100dollarhacker/atomic_force_microscope/README.md

This repository holds the files for creating simple diy atomic force microscope.
