100dollarhacker/atomic_force_microscope/samples/van_der_vaals_force.png

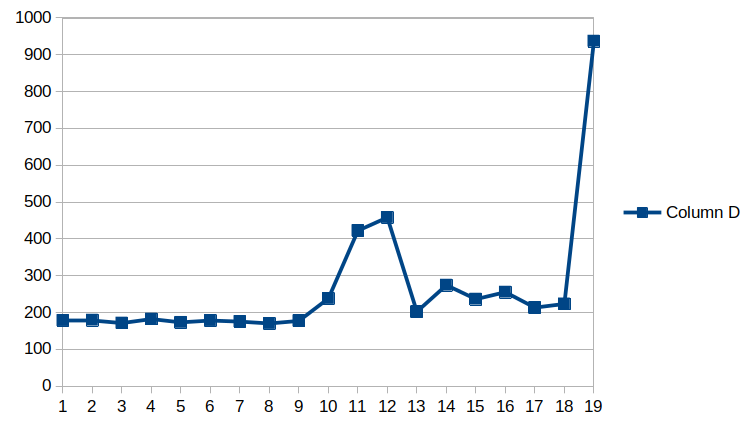
samples/van_der_vaals_force.png
