100dollarhacker/atomic_force_microscope/electric/AllBoardsBom.xlsx

PCBWay Bom Quotation, Product No.:T-2D39W751273A
Item # | *Designator | *Qty | *Mfg Part # | Description / Value | *Package/Footprint | *Unit Price(1 set) | *Total | *Delivery Time | *Actual Purchase Mfg Part # | *PCBWay Note | Customer Reply | PCBWay Update
1 | C4, C5, C6, C7, C8, C9 | 6 |  | 0.1uF『 』0.1UF-0603-25V-(+80/-20%)『 』0.1µF ceramic capacitors | 0603 | $0.098 | $0.588 |  | CC0603MRY5V8BB104
2 | 3C1, 3C3, 3C4, 3C11, 3C13, 3C15, 3C17 | 7 |  | 0.1uF『 』0.1UF-0603-50V-10%『 』0.1µF ceramic capacitors | 603 | $0.018 | $0.126 |  | CL10B104KB8NNNC
3 | 2C9, 2C11, 2C13 | 3 |  | 0.1uF『 』50V 10% X7R『 』CAPACITOR, European symbol | C0805 | $0.099 | $0.297 |  | 0805B104K500CT
4 | 2C1 | 1 |  | 1.0uF『 』1.0UF-0805-25V-10%『 』1µF ceramic capacitors | 0805 | $0.050 | $0.050 |  | 0805B105K250NT
5 | 1C13 | 1 |  | 1.0uF『 』1.0UF-0805『 』1µF ceramic capacitors 50V X7R 10% | 0805 | $0.050 | $0.050 |  | TCC0805X7R105K500DTS
6 | 3C6, 3C7 | 2 |  | 1.5nF『 』C-EUC0603 50v-10%『 』CAPACITOR, European symbol | 603 | $0.141 | $0.282 |  | 0603B152K500NT
7 | 3R4, 2R5,2R4 | 3 |  | 100k, 1/10W 1%『 』R-US_R0603『 』RESISTOR, American symbol | 603 | $0.041 | $0.123 |  | RC0603FR-07100KL
8 | C2, C3 | 2 |  | 100pF『 』100PF-0603-50V-5%『 』100pF/0.1nF ceramic capacitors | 0603 | $0.172 | $0.344 |  | 0603CG101J500NT
9 | 2R14, 2R15, 2R20 | 3 |  | 10k『 』RC-MASTER-SMD_R_0603MP『 』RESISTOR | RC-MASTER-SMD_R0603MP | $0.043 | $0.129 |  | RC0603FR-0710KL
10 | R6 | 1 |  | 10M『 』10MOHM-0603-1/4W-5%『 』1MΩ resistor | 0603 | $0.139 | $0.139 |  | ESR03EZPJ106
11 | 2C3, 2C5 | 2 |  | 10nF『 』10NF-0603-50V-10%『 』0.01uF/10nF/10,000pF ceramic capacitors | 0603 | $0.050 | $0.100 |  | CC0603KRX7R9BB103
12 | C1,3C2,1C15, 1C17 | 4 |  | 10nF『 』10NF-0603-50V-10%『 』0.01uF/10nF/10,000pF ceramic capacitors | 0603 | $0.066 | $0.264 |  | CC0603KRX7R9BB103
13 | 1C1, 1C10 | 2 |  | 10u『 』C-USC0603『 』CAPACITOR, American symbol 50V X7R 10% | 0603 | $0.078 | $0.156 |  | GRM188R61E106KA73D | 10uF ±10% 25V, X5R
14 | 1C2 | 1 |  | 10u『 』C-USC1210『 』CAPACITOR, American 50V X7R 10% | 1210 | $0.504 | $0.504 |  | 1210B106K500NT
15 | 2C8, 2C10, 2C12 | 3 |  | 10uF『 』10UF-0805-10V-10%『 』10.0µF ceramic capacitors | 0805 | $0.050 | $0.150 |  | TCC0805X5R106K100FT
16 | 2C2, 2C4, 2C6, 2C7 | 4 |  | 10uF『 』10UF-0805-25V-10%『 』10.0µF ceramic capacitors | 0805 | $0.050 | $0.200 |  | TCC0805X5R106K250FT
17 | 1C14, 1C16, 1C18, 1C19 | 4 |  | 10uF『 』10UF-0805-25V-10%『 』10.0µF ceramic capacitors 50V X7R 10% | 0805 | $0.105 | $0.420 |  | CL21B106KAYQNNE | 10uF ±10% 25V
18 | C10, C11 | 2 |  | 10uF『 』10UF-0805-50V-10%『 』10.0µF ceramic capacitors | 0805 | $0.147 | $0.294 |  | CL21A106KBYQNNE
19 | 3C5, 3C8, 3C12, 3C14, 3C16, 3C18 | 6 |  | 10uF『 』10UF-0805-50V-10%『 』10.0µF ceramic capacitors | 805 | $0.134 | $0.804 |  | CL21A106KBYQNNE
20 | 3R5 | 1 |  | 1k, 1/10W 1%『 』R-US_R0603『 』RESISTOR, American symbol | 603 | $0.127 | $0.127 |  | RC0603FR-071KL
21 | 1D2, 1D3, 1D5, 1D6 | 4 |  | 1n4007 (A7)『 』DIODE A7『 』DIODE | SOD123 | $0.603 | $2.412 | 7-10 Workdays | PMEG200G20ELR-QX
22 | 1C9, 1C11 | 2 |  | 1u『 』C-USC0603『 』CAPACITOR, American symbol 50V X7R 10% | 0603 | $0.050 | $0.100 |  | 0603B105K500NT
23 | 1C3 | 1 |  | 1u『 』C-USC1210『 』CAPACITOR, American symbol 50V X7R 10% | 1210 | $0.134 | $0.134 |  | CC1210KKX7R9BB105
24 | 2U$2, 2U$4, 2U$6, 2U$8 | 4 |  | 1uF『 』10% X7R『 』Generic chip capacitor | 0603 | $0.237 | $0.948 | 7-10 Workdays | 885012106030
25 | 2U$1, 2U$3, 2U$5, 2U$7 | 4 |  | 2.2uf『 』10% X7R『 』Generic chip capacitor | 0603 | $0.063 | $0.252 |  | GRM188R61E225KA12J
26 | 2R1,R5,1R3 | 3 |  | 220『 』220OHM-0603-1/10W-1%『 』220Ω resistor | 0603 | $0.054 | $0.162 |  | RC0603FR-07220RL
27 | 1C8 | 1 |  | 220u『 』CAPACITOR-P140CLH-1014『 』POLARIZED CAPACITOR, American symbol 50V X7R 10% | 140CLH-1014 | $1.764 | $1.764 | 7-10 Workdays | EEE-FP1H221AV
28 | 3Y1 | 1 |  | 25MHZ『 』OSCILLATORSMD-5X3『 』Oscillators (Generic) url: https://www.ebay.com/itm/364220200646 | 5X3.2mm | $2.245 | $2.245 | 7-10 Workdays | FT3MHUPM25.0-T1
29 | 1R6, 1R7 | 2 |  | 300k『 』300KOHM-0603-1/10W-1%『 』300KΩ 1% | 0603 | $0.086 | $0.172 |  | RC0603FR-07300KL
31 | 2R16, 2R17, 2R18, 2R19 | 4 |  | 30k『 』1/10W 1%『 』RESISTOR | RC-MASTER-SMD_R0603MP | $0.038 | $0.152 |  | RC0603FR-0730KL
32 | R4 | 1 |  | 4.7k『 』4.7KOHM-0603-1/10W-1%『 』4.7kΩ resistor | 0603 | $0.129 | $0.129 |  | RC0603FR-074K7L
33 | 2U$9 | 1 |  | 4.7uf『 』10% X7R『 』Generic chip capacitor | RESC0603_M | $0.147 | $0.147 |  | 06033D475KAT2A
34 | R3，R2 | 2 |  | 470『 』470OHM-0603-1/10W-1%『 』470Ω resistor | 0603 | $0.077 | $0.154 |  | RC0603FR-07470RL
35 | R2 | 1 |  | 470『 』47OHM-0603-1/10W-1%『 』47Ω resistor | 0603 |  |  |  | RMC1/16K4702FTP | [DNP不要贴];
36 | R1 | 1 |  | 47k『 』47KOHM-0603-1/10W-1%『 』47kΩ resistor | 0603 | $0.152 | $0.152 |  | RC0603FR-0747KL
37 | 3R1,3R2,3R6, 3R7, 3R8, 3R9 | 4 |  | 5.6k 1/10W 1%『 』R-US_R0603『 』RESISTOR, American symbol | 603 | $0.038 | $0.152 |  | RC0603FR-075K6L
38 | 2R6, 2R7, 2R8, 2R9, 2R10, 2R11, 2R12, 2R13 | 8 |  | 5k『 』1/10W-1%『 』RESISTOR | RC-MASTER-SMD_R0603MP | $0.019 | $0.152 |  | RTT035001FTP
39 | L3, L141 | 2 |  | 60Ohm@100 MHz『 』WE-CBF_0603_74279267_WB_HS『 』High Speed 60Ohm@100 MHz 110Ohm@650 MHz WE-CBF SMD EMI Suppression Ferrite Bead https://www.we-online.com/redexpert/spec/74279267?ae 2000mA SMT | 0603 | $0.315 | $0.630 |  | 74279267
40 | 3R3 | 1 |  | 7.2k， 1/10W 1%『 』R-US_R0603『 』RESISTOR, American symbol | 603 | $0.105 | $0.105 |  | AR03FTDX7201NA
41 | 1IC4 | 1 | 7805DT | 7805DT『 』7805DT『 』Positive VOLTAGE REGULATOR | TO252 | $0.440 | $0.440 |  | MC7805BDTG
42 | 1IC2 | 1 | 7815DT | 7815DT『 』7815DT『 』Positive VOLTAGE REGULATOR | TO252 | $0.592 | $0.592 |  | MC7815BDTRKG
43 | 2U2 | 1 |  | AD5696RARUZ-RL7RU_16_ADI-M『 』Analog Devices Inc『 』Quad, 26bit nano DAC. | RU_16_ADI-M | $29.458 | $29.458 | 7-10 Workdays | AD5696RARUZ
44 | U3 | 1 | AD8675ARMZ-REEL | AD8675ARMZ-REEL『 』Analog Devices『 』36 V Precision, 2.8 nV/√Hz Rail-to-Rail Output Op Amp | MSOP-8 | $2.730 | $2.730
45 | U2 | 1 | AD8676ARMZ | AD8676ARMZ『 』Analog Devices『 』Ultra Precision, 36 V, 2.8 nV/√Hz Dual RRO Op Amp | MSOP-8 | $4.410 | $4.410
46 | 3U1 | 1 | AD9833BRM | AD9833BRM『 』Analog Devices『 』Direct Digital Synthesizer 25MHz 1-DAC 10-Bit Serial | MSOP-10 | $19.918 | $19.918 | 7-10 Workdays | AD9833WBRMZ-REEL
47 | J1 | 1 |  | CONN_05PTH_LONGPADS『 』Multi connection point. Often used as Generic Header-pin footprint for 0.1 inch spaced/style header connections | 1X05_LONGPADS |  |  |  | HWS16310 | [DNP不要贴];
48 | 2U3 | 1 | LM324KAD | LM324KAD『 』Texas Instruments『 』Quad, 30-V, 1.2-MHz, 3-mV offset voltage | SOIC-14 | $0.630 | $0.630
49 | 3U3 | 1 | LM324KAD | LM324KAD『 』Texas Instruments『 』Quad, 30-V, 1.2-MHz, 3-mV offset voltage | SOIC-14 | $0.630 | $0.630
50 | 3U2 | 1 | LM339D | LM339D『 』Texas Instrument『 』Quad differential | SSOIC-14 | $0.919 | $0.919
51 | 2U1，1U2 | 2 | LTC3260EMSE#PBF | LTC3260EMSE#PBF『 』Analog Devices『 』Low Noise Dual Supply Inverting Charge Pump | MSOP-16 | $6.843 | $13.686
52 | U2 | 1 | LTC3260EMSE#PBF | LTC3260EMSE#PBF『 』LTC3260EMSE#PBF『 』Low Noise Dual Supply Inverting Charge Pump | MSOP-16_MSE |  |  |  |  | [DNP不要贴];
53 | U4 | 1 | OPA656U | OPA656U『 』Texas Instruments『 』Wideband, Unity Gain Stable FET-Input Operational Amplifier | SOIC-8 | $11.230 | $11.230 |  | OPA656UB/2K5
54 | 1J1 | 1 |  | POWER_JACKPOWER_JACK_SLOT『 』POWER_JACKPOWER_JACK_SLOT『 』Power Jack Connector 5.5mmx2.1mm | POWER_JACK_PTH_SLOT | $0.672 | $0.672 |  | PJ-102AH
55 | 3U4 | 1 | SN74LVC1G86DCKRG4 | SN74LVC1G86DCKRG4『 』Texas Instruments『 』Single 2-input, 1.65-V to 5.5-V XOR (exclusive OR) gate | SC70-5 | $0.414 | $0.414 | 7-10 Workdays
 | 1R4, 1R5, 2R3, 2R2 | 4 |  | 910K Ohm, 1/10W 1% | 0603 |  |  |  |  |  | New added
56 | USB TYPE A CONNECTOR | 1 | USBR-A-S-S-O-TH | USBR-A-S-S-O-TH『 』USBR-A-S-S-O-TH | SAMTEC_USBR-A-S-S-O-TH J4 | $2.674 | $2.674 | 7-10 Workdays
 |  |  |  |  |  | Component Cost | $103.51
 |  |  |  |  |  | Assembly Cost | $88.00
 |  |  |  |  |  | PCB Cost | $81.61
 |  |  |  |  |  | V0 Member 0% off | $0.00
 |  |  |  |  |  | All Total 1 Sets | $273.12
 |  |  |  |  |  | Build time | 23-25 days
