100dollarhacker/atomic_force_microscope/OpenAFM__converted_files/main board BOM.xlsx

Description | Example URL | Quantity | Label on PCB
20 Ohm surface mount resistor 0805 | http://china.rs-online.com/web/p/surface-mount-fixed-resistors/7217615/ | 1 | R7
1k surface mount resistors 0805 | http://china.rs-online.com/web/p/surface-mount-fixed-resistors/2230427/ | 1 | R1
4k7 surface mounts resistor 0805 | http://china.rs-online.com/web/p/surface-mount-fixed-resistors/2230528/ | 2 | R2, R3
10uF capacitor | http://china.rs-online.com/web/p/aluminium-capacitors/0117035/ | 3 | U4, C5, U8
10 pin female header | http://china.rs-online.com/web/p/pcb-sockets/7655745/ | 3 | J1, J5, Header for Arduino
2 pin male header | http://china.rs-online.com//web/p/pcb-headers/2518086/ (http://china.rs-online.com/web/p/pcb-headers/2518086/) | 2 | J6, J7,J3
220uF capacitors | http://china.rs-online.com/web/p/aluminium-capacitors/3150726/ | 2 | C16, C23
500k surface mount resistors 0805 | http://china.rs-online.com/web/p/surface-mount-fixed-resistors/6791437/ | 1 | R8
2A 100ohm ferrite bead | http://china.rs-online.com/web/p/ferrite-beads/6694159/?searchTerm=742792312 | 2 | U3, U34
L7809CV voltage regulator IC (TO-220V) | http://china.rs-online.com//web/p/linear-voltage-regulators/7140666/ (http://china.rs-online.com/web/p/linear-voltage-regulators/7140666/) | 1 | U6
L7805CV voltage regulator IC (TO-220V) | http://china.rs-online.com/web/p/linear-voltage-regulators/2988514/ | 1 | U7
LM4040 (SOT23) | http://china.rs-online.com/web/p/voltage-references/5457675/ | 1 | U9
24 pin 0.5mm pitch connector | http://uk.rs-online.com/web/p/fpc-connectors/8882721/ | 1 | U15
TVS SMB diode | http://china.rs-online.com//web/p/tvs-diodes/6287691/ (http://china.rs-online.com/web/p/tvs-diodes/6287691/) | 1 | U21
SPswitch on-off-on | http://china.rs-online.com/web/p/toggle-switches/1900557/ | 1 | U32
LM317TG single linear voltage regulator | http://china.rs-online.com/web/p/linear-voltage-regulators/5166240/ | 1 | U33
1uF SMT capacitors | http://china.rs-online.com/web/p/ceramic-multilayer-capacitors/4515770/ | 4 | C1, C3, C4, C17
100nF SMT capacitors | http://china.rs-online.com/web/p/ceramic-multilayer-capacitors/2644416/ | 2 | C2,C8
3 pin male header | http://china.rs-online.com/web/p/pcb-headers/2518092/ | 2 | J2, J4
