100dollarhacker/atomic_force_microscope/OpenAFM__converted_files/Piezo BOM.xlsx

Description | Quantity | URL | Comments | Positions on board
3.2uF surface mount capacitors 0805 | 6 | http://china.rs-online.com/web/p/ceramic-multilayer-capacitors/6911161/ | Can vary from 3-3.5 uF | DaC, Cref, Ca, Cd, Cc, Cb
10k surface mount resistors 0805 | 3 | http://china.rs-online.com/web/p/surface-mount-fixed-resistors/2230562/ | Can vary from 10 to 50kOhm | Rdv1, Rdv2,Rdr
1uF surface mount capacitors 0805 | 1 | http://china.rs-online.com/web/p/ceramic-multilayer-capacitors/4515770/ | Must be 1uF | Cf
5k surface mount resistors 0805 | 8 | http://china.rs-online.com/web/p/surface-mount-fixed-resistors/6791569/ | Can vary from 4.8k to 5.2k | Ra1, Rb1, Rc1, Rd1, Rfa, Rfd, Rfc, Rfb
DAC (AD5696RARUZ) | 1 | http://china.rs-online.com/web/p/general-purpose-dacs/8065471/ |  | DAC1
LTC3260 | 1 | http://china.rs-online.com/web/p/charge-pumps/8516768/ | mounted so that pin 1 is next to the dot | <Unlabelled>
100k surface mount resistors 0805 | 2 | http://china.rs-online.com/web/p/surface-mount-fixed-resistors/2230691/ | Can vary from 90k to 110k | RAGm, RAGp
800k surface mount resistors 0805 | 2 | http://china.rs-online.com/web/p/surface-mount-fixed-resistors/7087004/ | can vary from 780k to 820k | RLAm, RLAp
200k surface mount resistor 0805 | 1 | http://china.rs-online.com/web/p/surface-mount-fixed-resistors/6791064/ | has to be 200k | R14
30k surface mount resistors 0805 | 4 | http://china.rs-online.com/web/p/surface-mount-fixed-resistors/6791263/ | can vary from 28k to 32k | Ra2, Rb2, Rc2, Rd2
10uF surface mount capacitors 0805 | 5 | http://china.rs-online.com/web/p/ceramic-multilayer-capacitors/6911161/ | Should be as close as possible | LmC, LpC, ViC, VoC, OC
10nF surface mount capacitors 0805 | 2 | http://china.rs-online.com/web/p/ceramic-multilayer-capacitors/2644371/ | Should be as close as possible | BmC, BpC
5 pin male header | 1 | http://china.rs-online.com/web/p/pcb-headers/2518121/?searchTerm=W81105T3825RC |  | Piezos
LM324AD | 1 | http://china.rs-online.com/web/p/operational-amplifiers/5171876/ |  | LM324
