100dollarhacker/atomic_force_microscope/Mechanical/main_body.stl

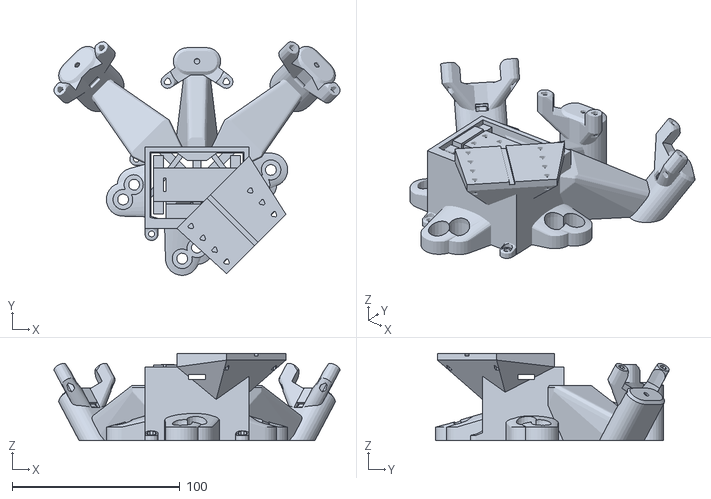
[picture p2: CAD file, 2023-10-08]
Mechanical/main_body.stl
170.5 x 139.3 x 52.0
