100dollarhacker/atomic_force_microscope/Mechanical/afm_nanoprobe_holder__up.stl

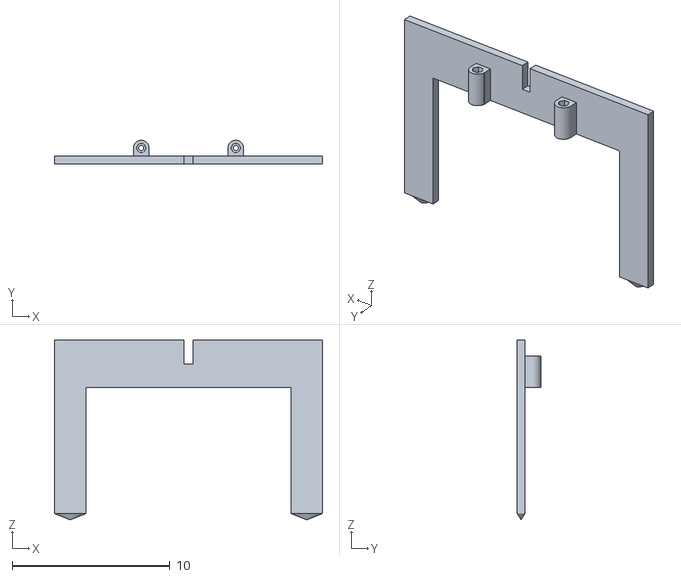
[picture p3: CAD file, 2024-08-04]
Mechanical/afm_nanoprobe_holder__up.stl
17.0 x 1.50 x 11.4
