100dollarhacker/atomic_force_microscope/NanoTipCreator3Dfiles/AFM_tiip_creator_part2.stl

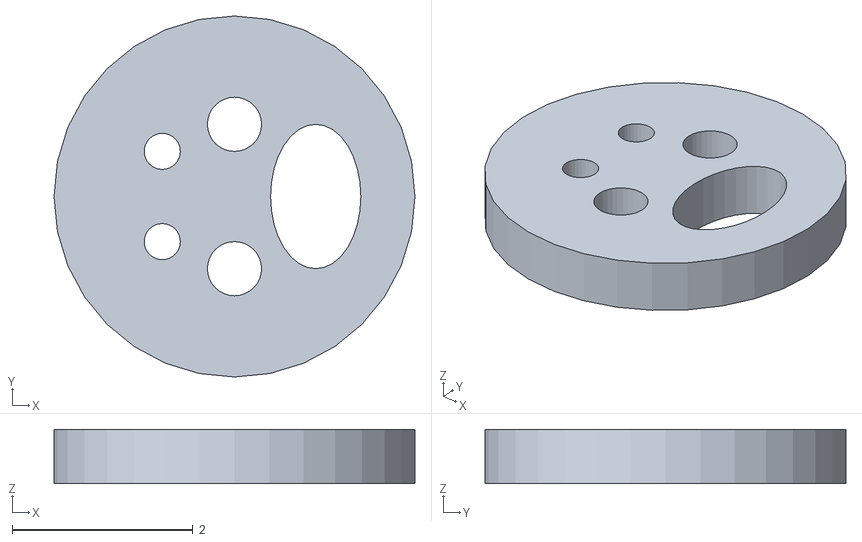
[picture p4: CAD file, 2023-07-18]
NanoTipCreator3Dfiles/AFM_tiip_creator_part2.stl
4.00 x 4.00 x 0.6
