100dollarhacker/atomic_force_microscope/NanoTipCreator3Dfiles/AFM_tiip_creator_part1.stl

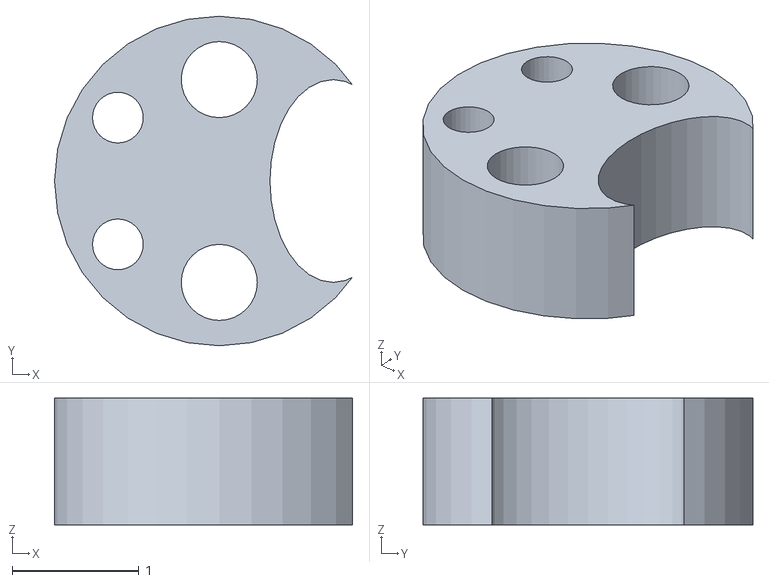
[picture p5: CAD file, 2023-07-18]
NanoTipCreator3Dfiles/AFM_tiip_creator_part1.stl
2.35 x 2.60 x 1.00
