100dollarhacker/atomic_force_microscope/Mechanical/gears.stl

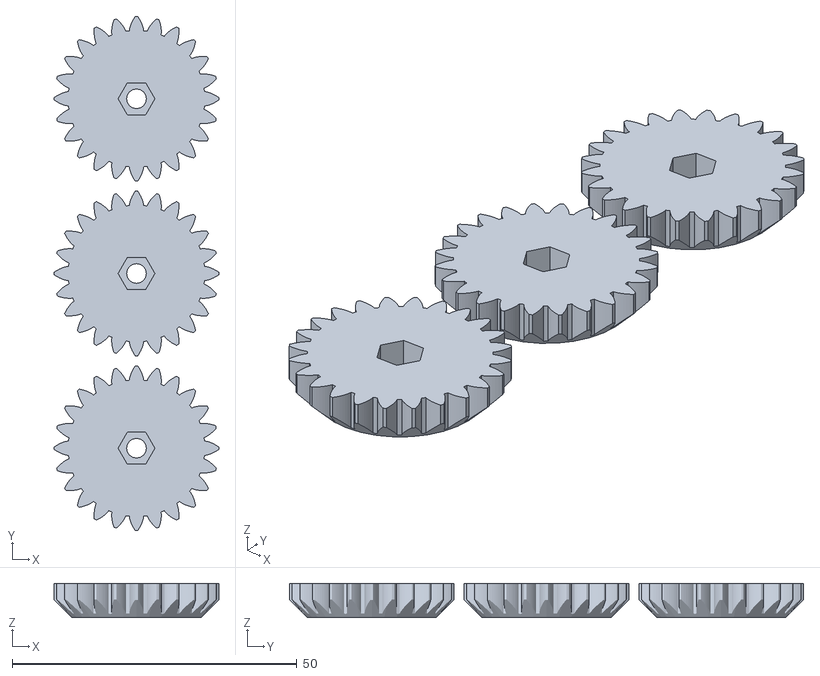
[picture p6: CAD file, 2023-10-08]
Mechanical/gears.stl
28.9 x 90.2 x 6.00
