100dollarhacker/atomic_force_microscope/Mechanical/base.stl

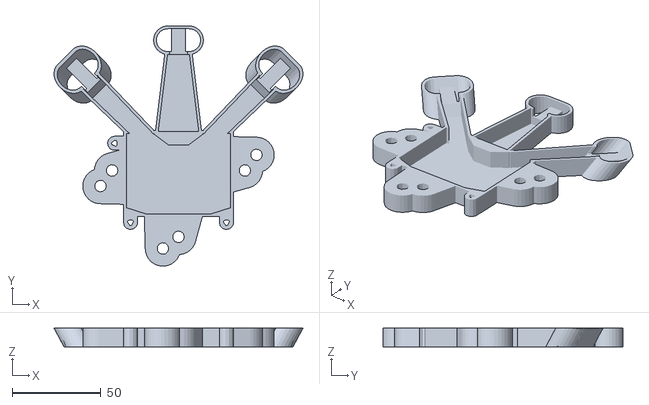
[picture p7: CAD file, 2023-10-08]
Mechanical/base.stl
140.6 x 135.7 x 10.5
