100dollarhacker/atomic_force_microscope/Mechanical/moving_platform.stl

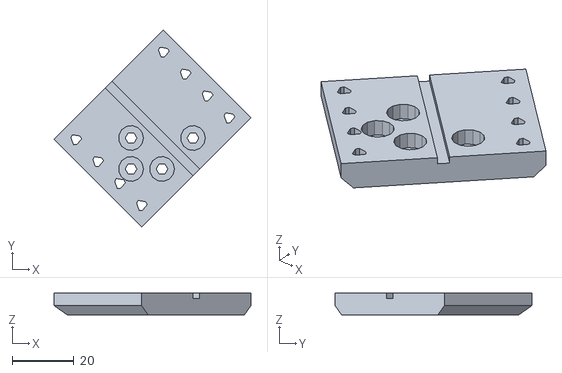
[picture p8: CAD file, 2023-10-08]
Mechanical/moving_platform.stl
63.6 x 63.6 x 7.00
