100dollarhacker/atomic_force_microscope/Mechanical/small_gears.stl

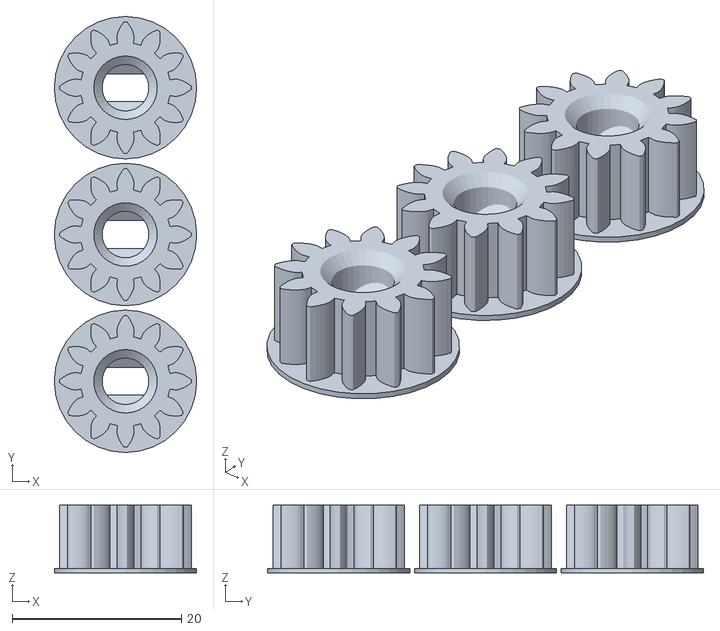
[picture p9: CAD file, 2023-10-08]
Mechanical/small_gears.stl
16.8 x 51.5 x 8.00
