100dollarhacker/atomic_force_microscope/Mechanical/finemovement.stl

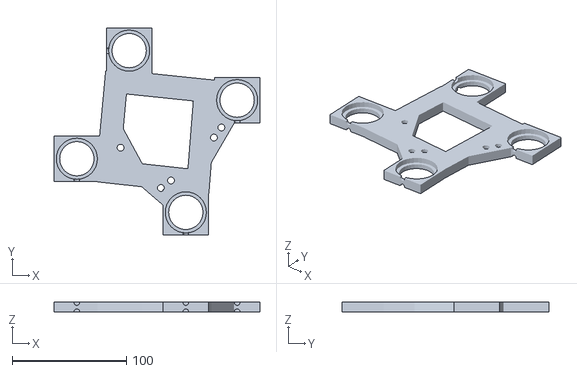
[picture p10: CAD file, 2023-10-08]
Mechanical/finemovement.stl
180.2 x 181.5 x 8.80
