100dollarhacker/atomic_force_microscope/(list of files, cad)

Other CAD files:
Mechanical/afm_nanoprobe_holder__down.stl
