100dollarhacker/atomic_force_microscope/electric/AFM_Power_board__NEW_SMD.brd

## EAGLE design electric/AFM_Power_board__NEW_SMD.brd (2024-12-30)

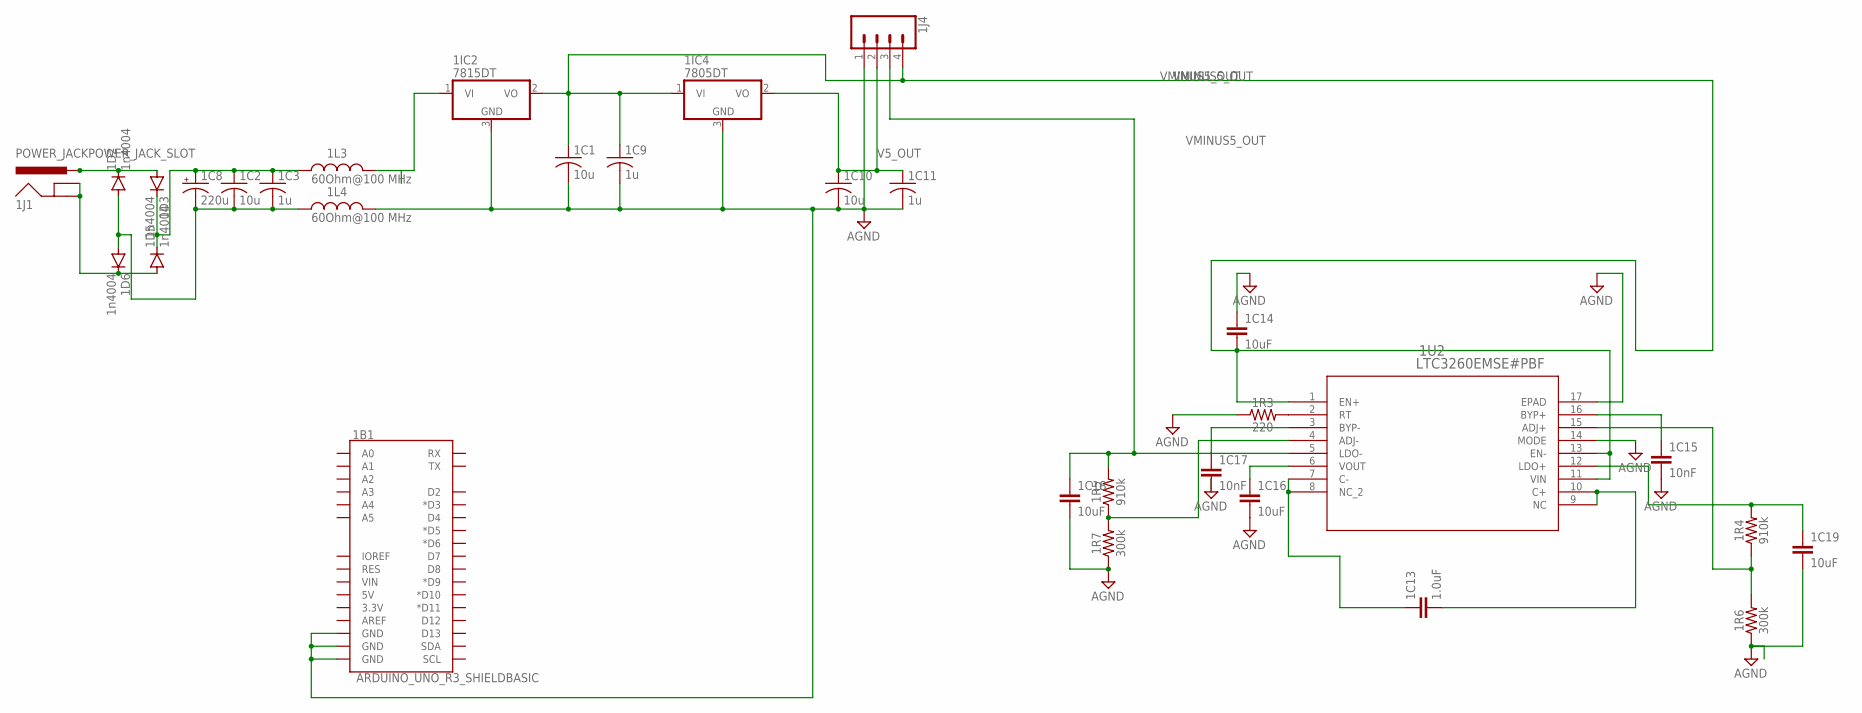
[picture p11: schematic AFM_Power_board__NEW_SMD.sch]

Parts:
1B1: ARDUINO_UNO_R3_SHIELDBASIC; UNO_R3_SHIELD
1C1, 1C10: 10u; C0603
1C2: 10u; C1210
1C3: 1u; C1210
1C8: 220u; 140CLH-1014
1C9, 1C11: 1u; C0603
1C13: 1.0uF; 0805
1C14, 1C16, 1C18, 1C19: 10uF; 0805
1C15, 1C17: 10nF; 0603
1D2, 1D3, 1D5, 1D6: 1n4004; SOD123
1IC2: 7815DT; TO252
1IC4: 7805DT; TO252
1J1: POWER_JACKPOWER_JACK_SLOT; POWER_JACK_PTH_SLOT
1J4: CONN_04LONGPADS; 1X04_LONGPADS
1L3, 1L4: 60Ohm@100 MHz; WE-CBF_0603_W2.2
1R3: 220; 0603
1R4, 1R5: 910k; 0603
1R6, 1R7: 300k; 0603
1U2: LTC3260EMSE#PBF; MSOP-16_MSE

Connections:
AGND: 1B1.GND@0 (GND), 1B1.GND@1 (GND), 1B1.GND@2 (GND), 1C1.2, 1C9.2, 1C10.2, 1C11.2, 1C14.1, 1C15.2, 1C16.2, 1C17.2, 1C18.2, 1C19.2, 1IC2.3 (GND), 1IC4.3 (GND), 1J4.1, 1L4.2, 1R3.1, 1R6.1, 1R7.1, 1U2.14 (MODE), 1U2.17 (EPAD)
GROUND: 1C2.2, 1C3.2, 1C8.-, 1D2.A, 1D6.A, 1L4.1
LDO+: 1C19.1, 1R4.2, 1U2.12 (LDO+)
unnamed: 1D5.A, 1D6.C, 1J1.GND, 1J1.GNDBREAK
unnamed: 1IC2.1 (VI), 1L3.2
unnamed: 1C13.1, 1U2.7 (C-), 1U2.8 (NC_2)
unnamed: 1C13.2, 1U2.9 (NC), 1U2.10 (C+)
unnamed: 1C2.1, 1C3.1, 1C8.+, 1D3.C, 1D5.C, 1L3.1
unnamed: 1C17.1, 1U2.3 (BYP-)
unnamed: 1C15.1, 1U2.16 (BYP+)
unnamed: 1C16.1, 1U2.6 (VOUT)
unnamed: 1R3.2, 1U2.2 (RT)
unnamed: 1R5.1, 1R7.2, 1U2.4 (ADJ-)
unnamed: 1R4.1, 1R6.2, 1U2.15 (ADJ+)
POWERP: 1D2.C, 1D3.A, 1J1.PWR
V5_OUT: 1C10.1, 1C11.1, 1IC4.2 (VO), 1J4.2
V15+: 1C1.1, 1C9.1, 1C14.2, 1IC2.2 (VO), 1IC4.1 (VI), 1J4.4, 1U2.1 (EN+), 1U2.11 (VIN), 1U2.13 (EN-)
VMINUS5_OUT: 1C18.1, 1J4.3, 1R5.2, 1U2.5 (LDO-)

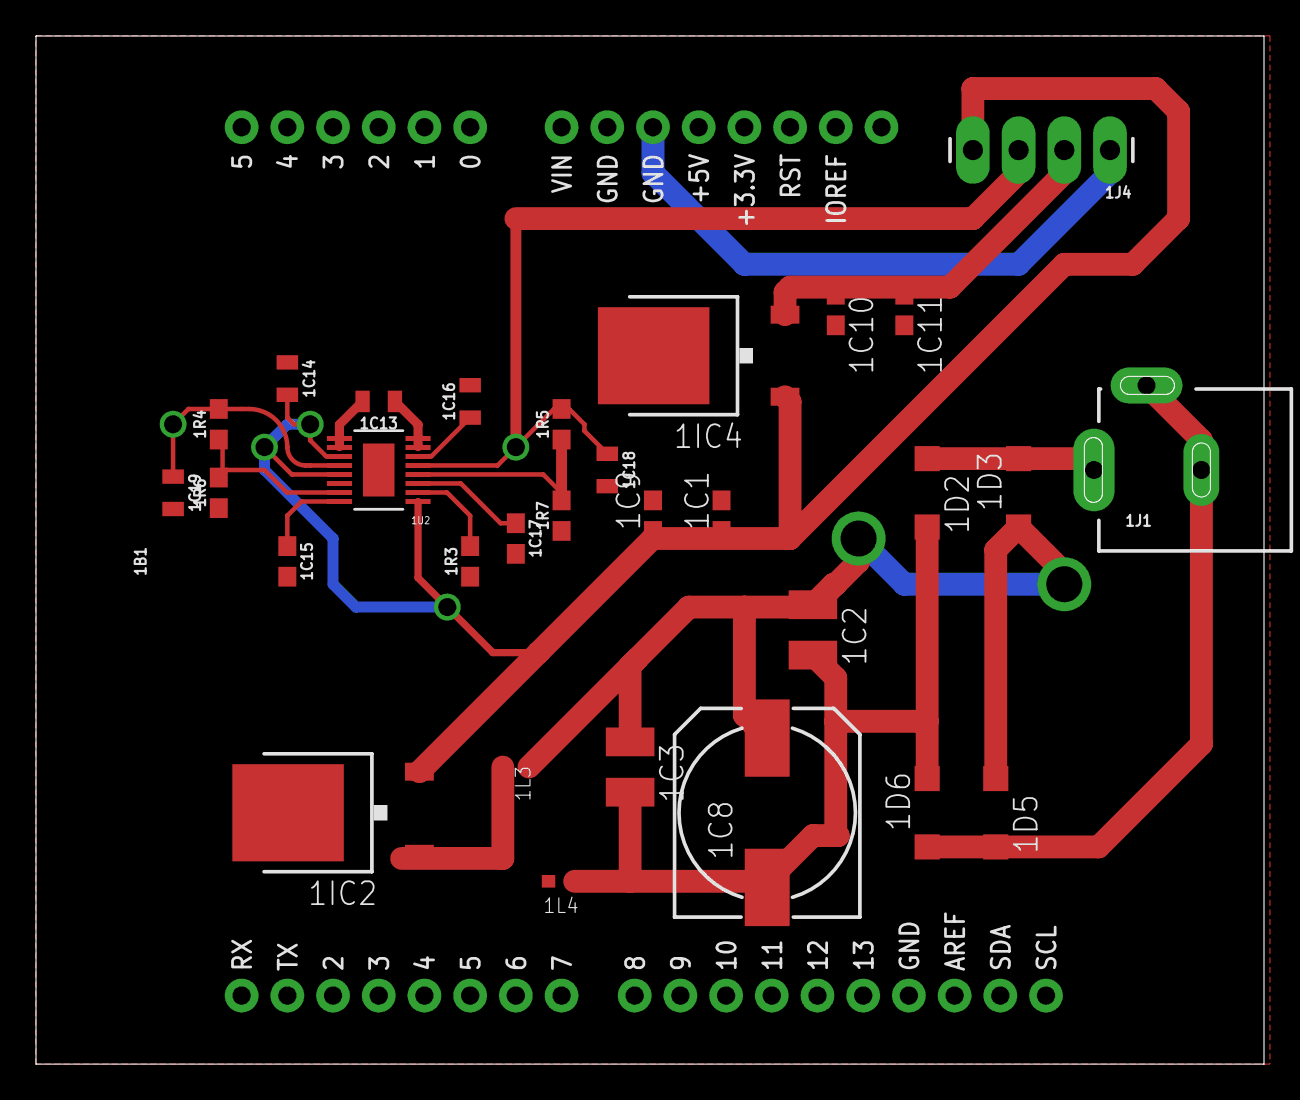
[picture p12: board AFM_Power_board__NEW_SMD.brd from above]

Board: 2 copper layers, 68.2 x 57.1 mm, 31 parts (0 on the bottom side), 18 nets.
