100dollarhacker/atomic_force_microscope/electric/AFM_QFM_Piezo_controller.brd

## EAGLE design electric/AFM_QFM_Piezo_controller.brd (2024-12-30)

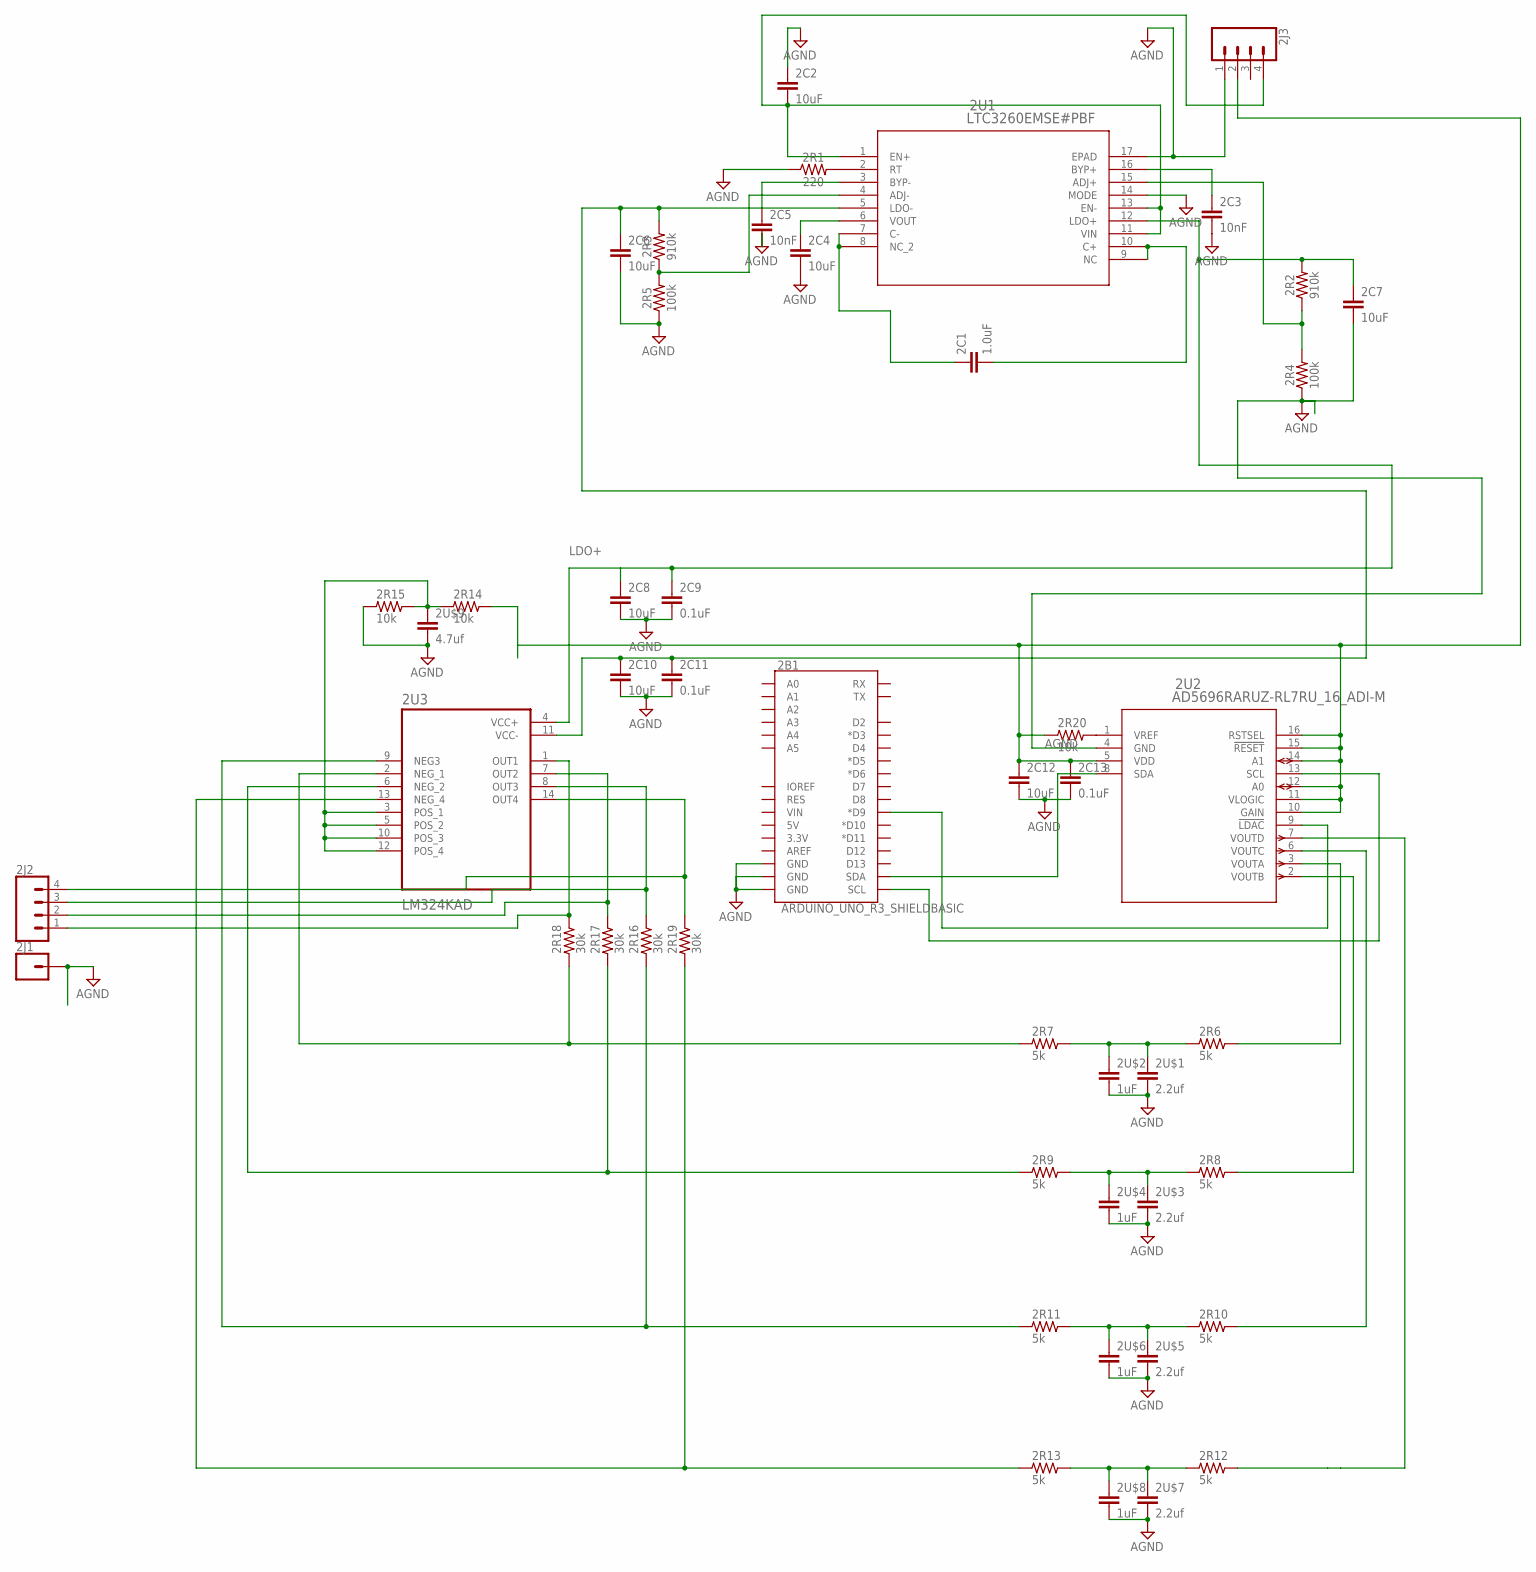
[picture p13: schematic AFM_QFM_Piezo_controller.sch]

Parts:
2B1: ARDUINO_UNO_R3_SHIELDBASIC; UNO_R3_SHIELD
2C1: 1.0uF; 0805
2C2, 2C4, 2C6, 2C7, 2C8, 2C10, 2C12: 10uF; 0805
2C3, 2C5: 10nF; 0603
2C9, 2C11, 2C13: 0.1uF; C0805
2J1: CONN_01PTH_LONGPAD; 1X01_LONGPAD
2J2, 2J3: CONN_04LONGPADS; 1X04_LONGPADS
2R1: 220; 0603
2R2, 2R3: 910k; 0603
2R4, 2R5: 100k; 0603
2R6, 2R7, 2R8, 2R9, 2R10, 2R11, 2R12, 2R13: 5k; RC-MASTER-SMD_R0603MP
2R14, 2R15, 2R20: 10k; RC-MASTER-SMD_R0603MP
2R16, 2R17, 2R18, 2R19: 30k; RC-MASTER-SMD_R0603MP
2U1: LTC3260EMSE#PBF; MSOP-16_MSE
2U2: AD5696RARUZ-RL7RU_16_ADI-M; RU_16_ADI-M
2U3: LM324KAD; SOIC127P600X175-14N
2U$1, 2U$3, 2U$5, 2U$7: 2.2uf; RESC0603_M
2U$2, 2U$4, 2U$6, 2U$8: 1uF; RESC0603_M
2U$9: 4.7uf; RESC0603_M

Connections:
AGND: 2B1.GND@0 (GND), 2B1.GND@1 (GND), 2B1.GND@2 (GND), 2C2.1, 2C3.2, 2C4.2, 2C5.2, 2C6.2, 2C7.2, 2C8.2, 2C9.2, 2C10.2, 2C11.2, 2C12.2, 2C13.2, 2J1.1, 2J3.1, 2R1.1, 2R4.1, 2R5.1, 2R15.1, 2U1.14 (MODE), 2U1.17 (EPAD), 2U2.4 (GND), 2U$1.2, 2U$2.2, 2U$3.2, 2U$4.2, 2U$5.2, 2U$6.2, 2U$7.2, 2U$8.2, 2U$9.2
LDAC: 2B1.D9 (*D9), 2U2.9 (!LDAC)
LDO+: 2C7.1, 2C8.1, 2C9.1, 2R2.2, 2U1.12 (LDO+), 2U3.4 (VCC+)
LDO-: 2C6.1, 2C10.1, 2C11.1, 2R3.2, 2U1.5 (LDO-), 2U3.11 (VCC-)
unnamed: 2C5.1, 2U1.3 (BYP-)
unnamed: 2R1.2, 2U1.2 (RT)
unnamed: 2C1.1, 2U1.7 (C-), 2U1.8 (NC_2)
unnamed: 2C1.2, 2U1.9 (NC), 2U1.10 (C+)
unnamed: 2C3.1, 2U1.16 (BYP+)
unnamed: 2C4.1, 2U1.6 (VOUT)
unnamed: 2R3.1, 2R5.2, 2U1.4 (ADJ-)
unnamed: 2R6.1, 2R7.2, 2U$1.1, 2U$2.1
unnamed: 2R2.1, 2R4.2, 2U1.15 (ADJ+)
unnamed: 2R7.1, 2R18.1, 2U3.2 (NEG_1)
unnamed: 2R8.1, 2R9.2, 2U$3.1, 2U$4.1
unnamed: 2R9.1, 2R17.1, 2U3.6 (NEG_2)
unnamed: 2R10.1, 2R11.2, 2U$5.1, 2U$6.1
unnamed: 2R11.1, 2R16.1, 2U3.9 (NEG3)
unnamed: 2R12.1, 2R13.2, 2U$7.1, 2U$8.1
unnamed: 2R13.1, 2R19.1, 2U3.13 (NEG_4)
unnamed: 2R20.2, 2U2.1 (VREF)
P_OUT1: 2J2.1, 2R18.2, 2U3.1 (OUT1)
P_OUT2: 2J2.2, 2R17.2, 2U3.7 (OUT2)
P_OUT3: 2J2.3, 2R16.2, 2U3.8 (OUT3)
P_OUT4: 2J2.4, 2R19.2, 2U3.14 (OUT4)
SCL: 2B1.SCL, 2U2.13 (SCL)
SDA: 2B1.SDA, 2U2.8 (SDA)
V15+: 2C2.2, 2J3.4, 2U1.1 (EN+), 2U1.11 (VIN), 2U1.13 (EN-)
VDD: 2C12.1, 2C13.1, 2J3.2, 2R14.2, 2R20.1, 2U2.5 (VDD), 2U2.10 (GAIN), 2U2.11 (VLOGIC), 2U2.12 (A0), 2U2.14 (A1), 2U2.15 (!RESET), 2U2.16 (RSTSEL)
VOUTA: 2R6.2, 2U2.3 (VOUTA)
VOUTB: 2R8.2, 2U2.2 (VOUTB)
VOUTC: 2R10.2, 2U2.6 (VOUTC)
VOUTD: 2R12.2, 2U2.7 (VOUTD)
V_REF: 2R14.1, 2R15.2, 2U3.3 (POS_1), 2U3.5 (POS_2), 2U3.10 (POS_3), 2U3.12 (POS_4), 2U$9.1

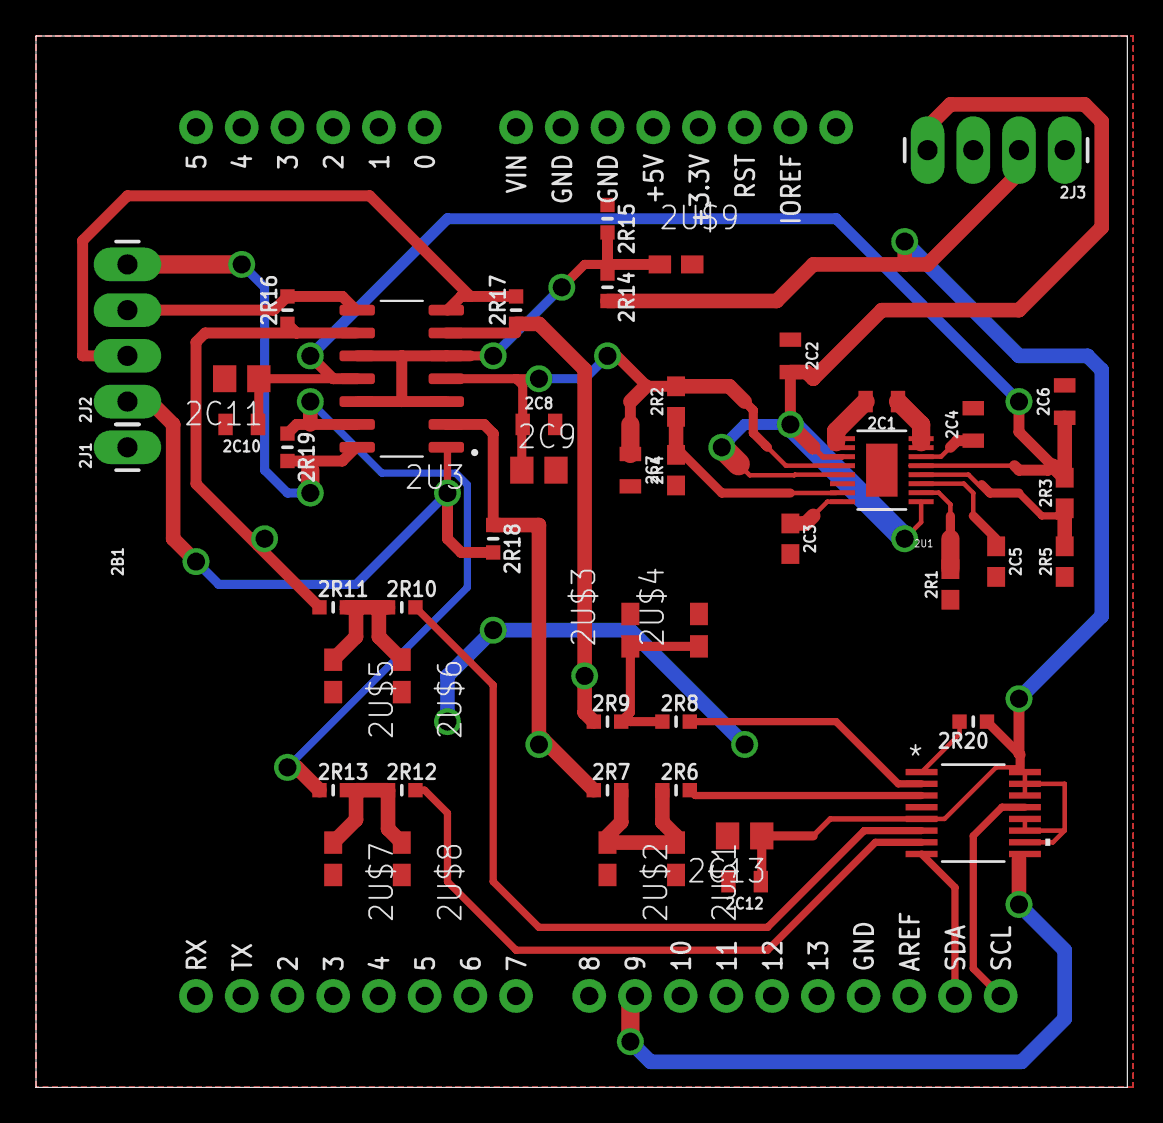
[picture p14: board AFM_QFM_Piezo_controller.brd from above]

Board: 2 copper layers, 60.6 x 58.4 mm, 49 parts (0 on the bottom side), 34 nets.
