100dollarhacker/atomic_force_microscope/electric/AFM_QFM_input.brd

## EAGLE design electric/AFM_QFM_input.brd (2024-12-30)

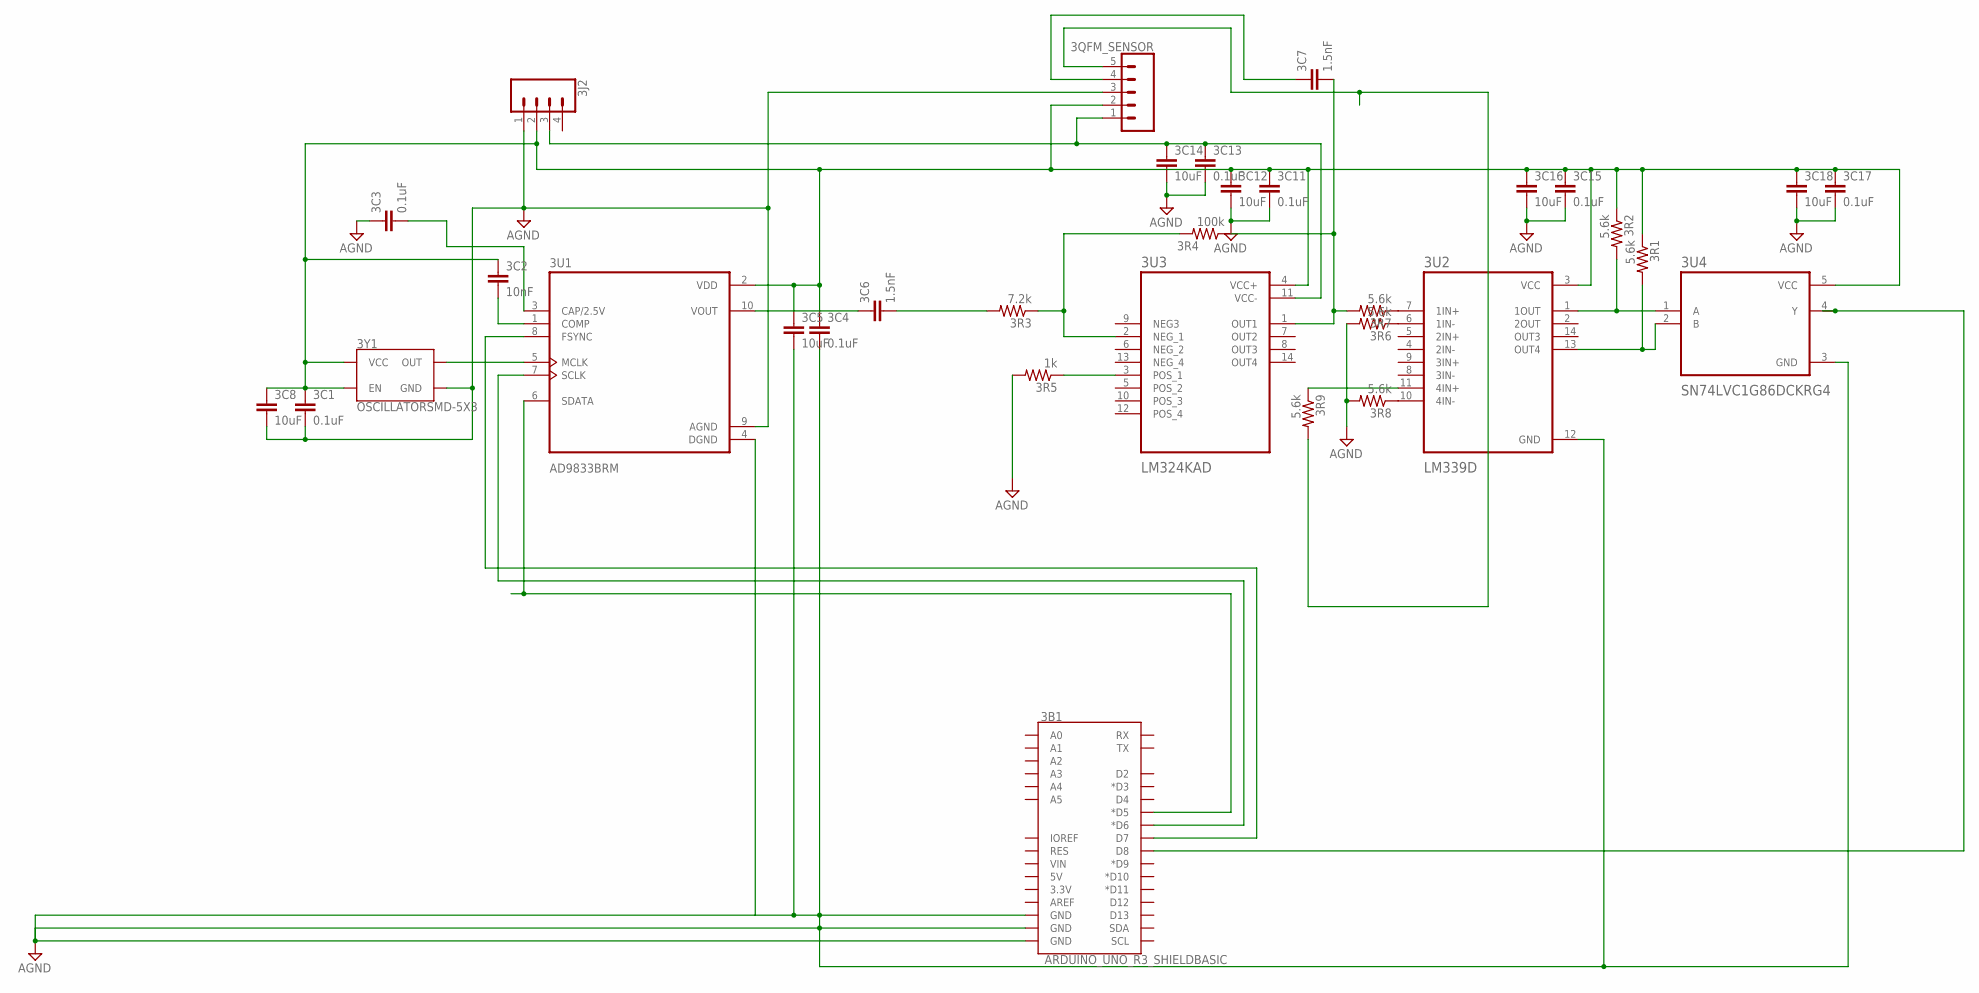
[picture p15: schematic AFM_QFM_input.sch]

Parts:
3B1: ARDUINO_UNO_R3_SHIELDBASIC; UNO_R3_SHIELD
3C1, 3C3, 3C4, 3C11, 3C13, 3C15, 3C17: 0.1uF; 0603
3C2: 10nF; 0603
3C5, 3C8, 3C12, 3C14, 3C16, 3C18: 10uF; 0805
3C6, 3C7: 1.5nF; C0603
3J2: CONN_04LONGPADS; 1X04_LONGPADS
3QFM_SENSOR: CONN_05PTH_LONGPADS; 1X05_LONGPADS
3R1, 3R2, 3R6, 3R7, 3R8, 3R9: 5.6k; R0603
3R3: 7.2k; R0603
3R4: 100k; R0603
3R5: 1k; R0603
3U1: AD9833BRM; SOP50P490X110-10N
3U2: LM339D; SOIC127P600X175-14N
3U3: LM324KAD; SOIC127P600X175-14N
3U4: SN74LVC1G86DCKRG4; SOT65P210X110-5N
3Y1: OSCILLATORSMD-5X3; OSCILLATOR-SMD-5X3.2

Connections:
AGND: 3B1.GND@0 (GND), 3B1.GND@1 (GND), 3B1.GND@2 (GND), 3C1.2, 3C3.1, 3C4.2, 3C5.2, 3C8.2, 3C11.2, 3C12.2, 3C13.2, 3C14.2, 3C15.2, 3C16.2, 3C17.2, 3C18.2, 3J2.1, 3QFM_SENSOR.3, 3R5.2, 3R6.2, 3R8.2, 3U1.4 (DGND), 3U1.9 (AGND), 3U2.12 (GND), 3U4.3 (GND), 3Y1.2 (GND)
unnamed: 3B1.D7, 3U1.8 (FSYNC)
unnamed: 3U1.5 (MCLK), 3Y1.3 (OUT)
unnamed: 3B1.D6 (*D6), 3U1.7 (SCLK)
unnamed: 3B1.D5 (*D5), 3U1.6 (SDATA)
unnamed: 3C2.2, 3U1.1 (COMP)
unnamed: 3C6.1, 3U1.10 (VOUT)
unnamed: 3C3.2, 3U1.3 (CAP/2.5V)
unnamed: 3C6.2, 3R3.2
unnamed: 3R3.1, 3R4.2, 3U3.2 (NEG_1)
unnamed: 3C7.1, 3QFM_SENSOR.4
unnamed: 3C7.2, 3R4.1, 3R7.2, 3U3.1 (OUT1)
unnamed: 3R5.1, 3U3.3 (POS_1)
unnamed: 3R6.1, 3U2.6 (1IN-)
unnamed: 3R7.1, 3U2.7 (1IN+)
unnamed: 3R2.2, 3U2.1 (1OUT), 3U4.1 (A)
unnamed: 3R8.1, 3U2.10 (4IN-)
unnamed: 3R9.1, 3U2.11 (4IN+)
unnamed: 3QFM_SENSOR.5, 3R9.2
unnamed: 3R1.2, 3U2.13 (OUT4), 3U4.2 (B)
unnamed: 3B1.D8, 3U4.4 (Y)
VCC: 3C13.1, 3C14.1, 3J2.3, 3QFM_SENSOR.1, 3U3.11 (VCC-)
VDD3: 3C1.1, 3C2.1, 3C4.1, 3C5.1, 3C8.1, 3C11.1, 3C12.1, 3C15.1, 3C16.1, 3C17.1, 3C18.1, 3J2.2, 3QFM_SENSOR.2, 3R1.1, 3R2.1, 3U1.2 (VDD), 3U2.3 (VCC), 3U3.4 (VCC+), 3U4.5 (VCC), 3Y1.1 (EN), 3Y1.4 (VCC)

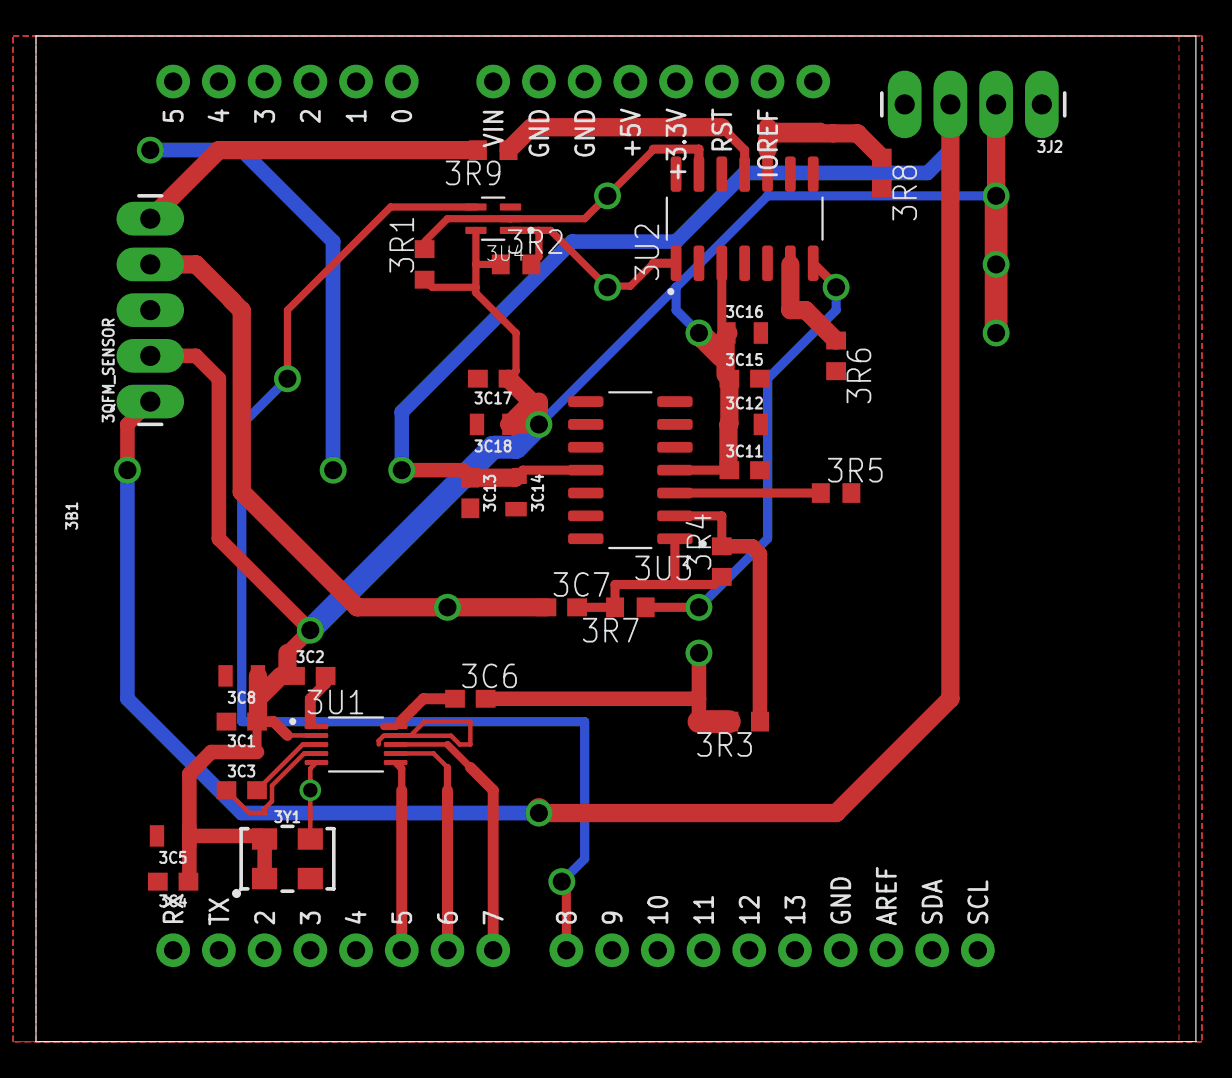
[picture p16: board AFM_QFM_input.brd from above]

Board: 2 copper layers, 64.4 x 55.9 mm, 33 parts (0 on the bottom side), 23 nets.
