100dollarhacker/atomic_force_microscope/electric/5LongConnector.brd

## EAGLE design electric/5LongConnector.brd (2024-12-30)

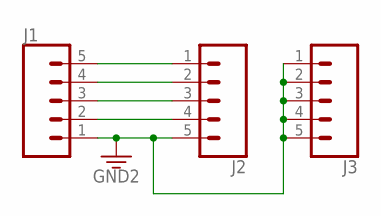
[picture p17: schematic 5LongConnector.sch]

Parts:
J1, J2, J3: CONN_05PTH_LONGPADS; 1X05_LONGPADS

Connections:
3.3V: J1.1, J2.5, J3.1, J3.2, J3.3, J3.4, J3.5
unnamed: J1.5, J2.1
unnamed: J1.4, J2.2
unnamed: J1.3, J2.3
unnamed: J1.2, J2.4

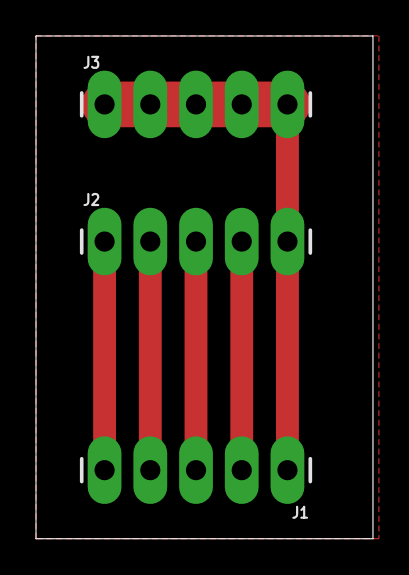
[picture p18: board 5LongConnector.brd from above]

Board: 2 copper layers, 18.7 x 27.9 mm, 3 parts (0 on the bottom side), 5 nets.
