100dollarhacker/atomic_force_microscope/electric/AFM_QFM_sensor_OPA656NB.brd

## EAGLE design electric/AFM_QFM_sensor_OPA656NB.brd (2024-11-04)

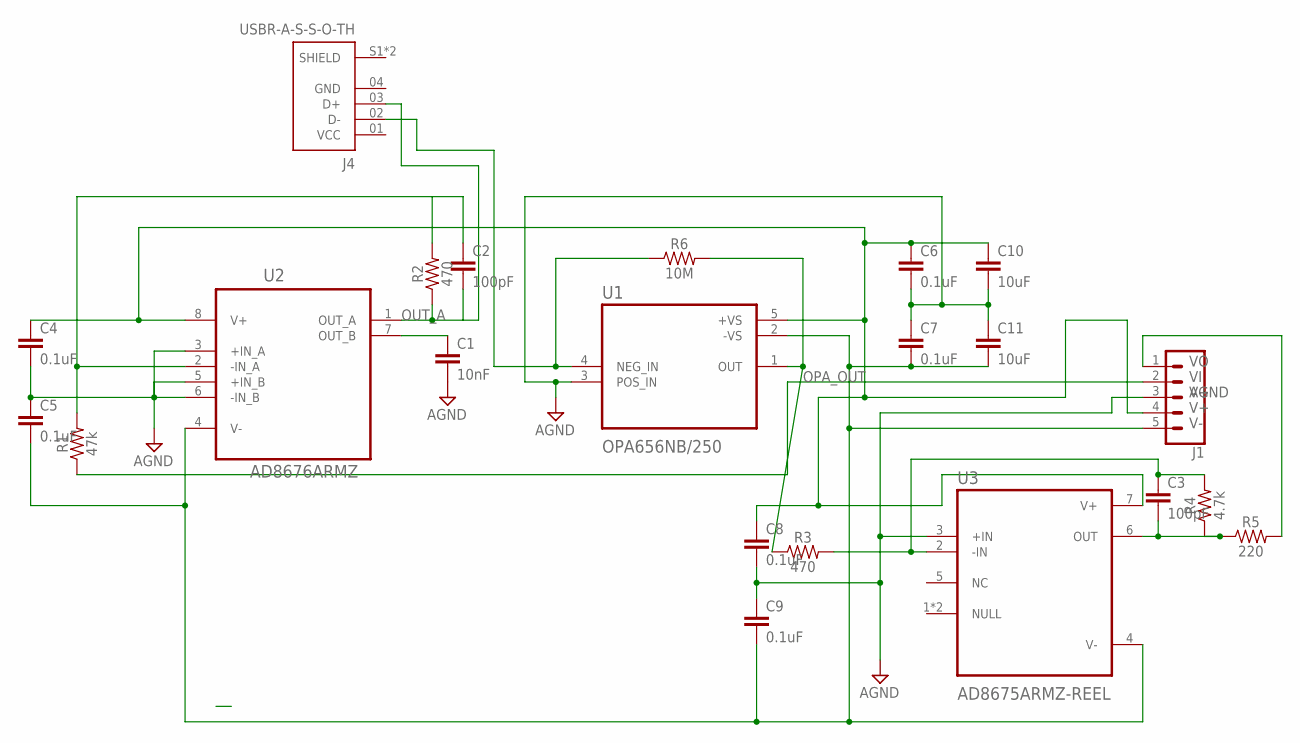
[picture p19: schematic AFM_QFM_sensor_OPA656NB.sch]

Parts:
C1: 10nF; 0603
C2, C3: 100pF; 0603
C4, C5, C6, C7, C8, C9: 0.1uF; 0603
C10, C11: 10uF; 0805
J1: CONN_05PTH_LONGPADS; 1X05_LONGPADS
J4: USBR-A-S-S-O-TH; SAMTEC_USBR-A-S-S-O-TH
R1: 47k; 0603
R2, R3: 470; 0603
R4: 4.7k; 0603
R5: 220; 0603
R6: 10M; 0603
U1: OPA656NB/250; SOT95P280X145-5N
U2: AD8676ARMZ; SOP65P490X110-8N
U3: AD8675ARMZ-REEL; SOP65P490X110-8N

Connections:
AGND: C1.2, C4.2, C5.1, C6.2, C7.1, C8.2, C9.1, C10.2, C11.1, J1.3, U1.3 (POS_IN), U2.3 (+IN_A), U2.5 (+IN_B), U2.6 (-IN_B), U3.3 (+IN)
GND: J4.04 (GND)
unnamed: J4.02 (D-), R6.1, U1.4 (NEG_IN)
unnamed: C1.1, U2.7 (OUT_B)
unnamed: C2.1, R1.2, R2.2, U2.2 (-IN_A)
unnamed: C3.2, R4.1, R5.1, U3.6 (OUT)
OPA_OUT: C3.1, R3.1, R3.2, R4.2, R6.2, U1.1 (OUT), U3.2 (-IN)
OUT_A: C2.2, J4.03 (D+), R2.1, U2.1 (OUT_A)
V+: C4.1, C6.1, C8.1, C10.1, J1.4, U1.5 (+VS), U2.8 (V+), U3.7 (V+)
V-: C5.2, C7.2, C9.2, C11.2, J1.5, U1.2 (-VS), U2.4 (V-), U3.4 (V-)
VCC: J4.01 (VCC)
VI: J1.2, R1.1
VO: J1.1, R5.2

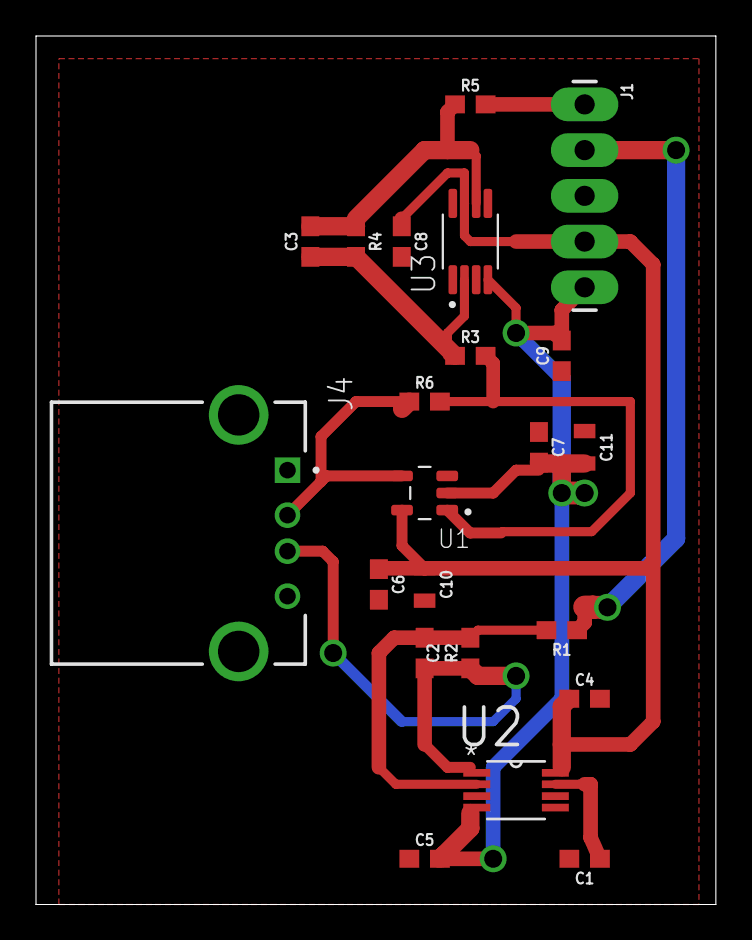
[picture p20: board AFM_QFM_sensor_OPA656NB.brd from above]

Board: 2 copper layers, 37.8 x 48.2 mm, 22 parts (0 on the bottom side), 11 nets.
