100dollarhacker/atomic_force_microscope/OpenAFM__converted_files/mainboard.brd

## EAGLE design OpenAFM__converted_files/mainboard.brd (2023-07-21)

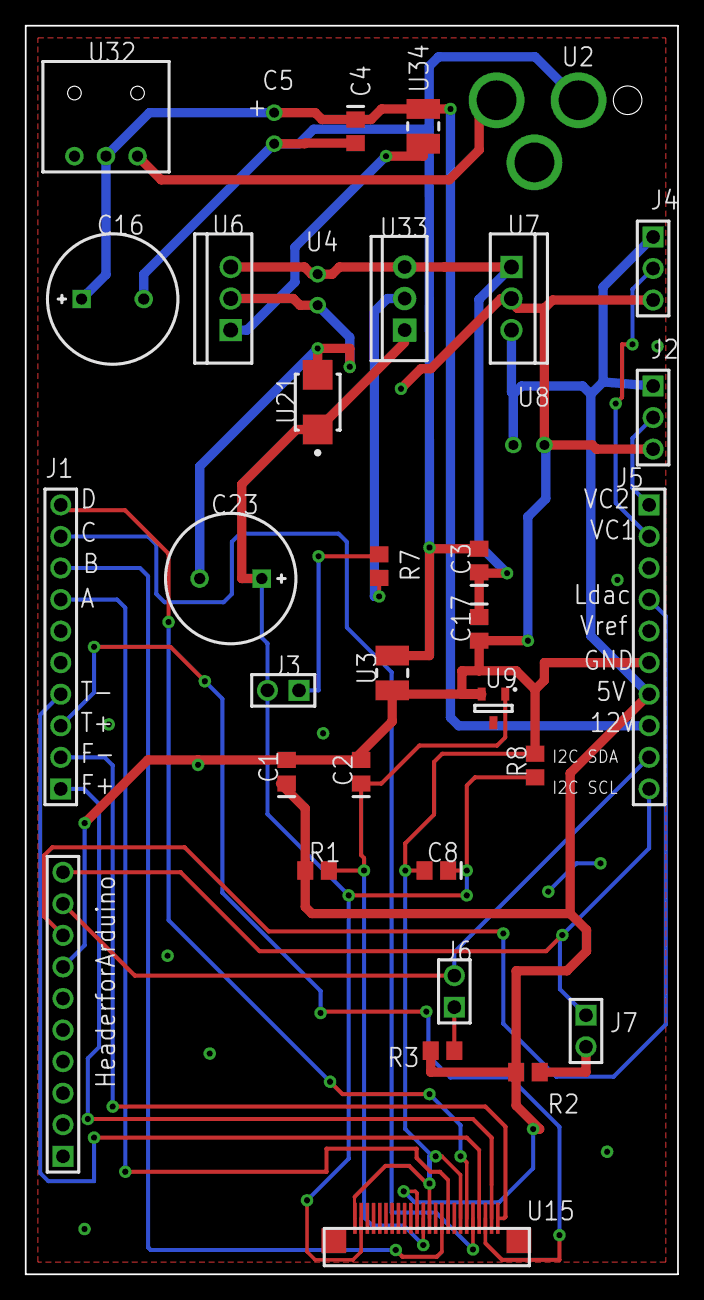
[picture p21: board mainboard.brd from above]

Board: 2 copper layers, 52.5 x 100.5 mm, 34 parts (0 on the bottom side), 26 nets.

Parts:
C1, C3: 1u; CAP_0805
C2: 0u1; CAP_0805
C4: 1u; CAP_0805_C4
C5: 10UF CAP; CAPR-2.5/6.3h11
C8: 0u1; CAP_0805_C8
C16: 220UF CAP; CAPPR-5/10.5h14
C17: 1u; CAP_0805_C8
C23: 220UF CAP; CAPPR-5/10.5h14_C23
HeaderforArduino: 1-644456-0; HDR-1x10T/2.54/25x2_HeaderforArduino
J1: TVS3V5; HDR-1x10T/2.54/25x2
J2, J4: 644456-3; HDR-1x3T/2.54/7x2
J3: 90131-0121; HDR-2x1T/2.54x2.54/3x5
J5: 1-644456-0; HDR-1x10T/2.54/25x2_J5
J6: 90131-0121; HDR-2x1T/2.54x2.54/3x5_J6
J7: 90131-0121; HDR-2x1T/2.54x2.54/3x5_J7
R1: 1k; RES_0805
R2: 4k7; RES_0805_R2
R3: 4k7; RES_0805_R3
R7: 20R; RES_0805_R7
R8: 500k; RES_0805_R8
U2: DCJACK2.1MM; DCJack2.1mm
U3: 2A,45ohm; RES_1210
U4: 10UF CAP; CAPR-2.5/6.3h11
U6: L7809CV; TO-220V
U7: L7805CV; TO-220V_U7
U8: 10UF CAP; CAPR-2.5/6.3h11_U8
U9: 2.048V ref; SOT23
U15: SF-HD65 CONNECTOR; 24Pin_Flex_.5mm_Pitch
U21: TVS3V5; SMB
U32: SPSWITCH; SPswitch
U33: LM317T; TO-220
U34: 2A,45ohm; RES_1210_U34

Connections:
2V1: C2.1, R1.2, U9.1, U15.13
5V: C1.1, J2.1, J4.1, J5.7, R1.1, R2.2, R3.2, U7.2, U8.1, U15.14
9V: C3.1, C17.1, U4.1, U6.2, U7.1, U33.3
GND: C1.2, C2.2, C8.2, C17.2, C23.2, HeaderforArduino.7, J2.3, J4.3, J5.6, R8.1, U3.1, U4.2, U6.3, U7.3, U8.2, U9.2, U15.7, U15.12, U15.24, U21.2
GND_digi: C3.2, C4.2, C5.2, C16.2, U2.2, U3.2
Net_1: C4.1, C5.1, C16.1, J5.8, U32.2, U34.1
Net_4: J1.7, U15.9
Net_5: J1.8, U15.10
Net_6: J1.9, U15.5
Net_7: J1.10, U15.6
Net_8: J1.2, U15.1
Net_9: J1.1, U15.2
Net_10: J1.3, U15.3
Net_11: J1.4, U15.4
Net_16: J3.1, R7.2
Net_17: R7.1, U33.2
Net_18: C8.1, C23.1, J3.2, R8.2, U15.23, U21.1, U33.1
Net_19: HeaderforArduino.10, J5.10, J7.1
Net_20: HeaderforArduino.9, J5.9, J6.2
Net_21: HeaderforArduino.8, J5.4
Net_22: J4.2, J5.2
Net_23: J2.2, J5.1
Net_24: J6.1, R3.1
Net_25: J7.2, R2.1
Net_65: U2.1, U32.1
Net_72: U6.1, U34.2
