100dollarhacker/atomic_force_microscope/OpenAFM__converted_files/piezoboard.brd

## EAGLE design OpenAFM__converted_files/piezoboard.brd (2023-07-21)

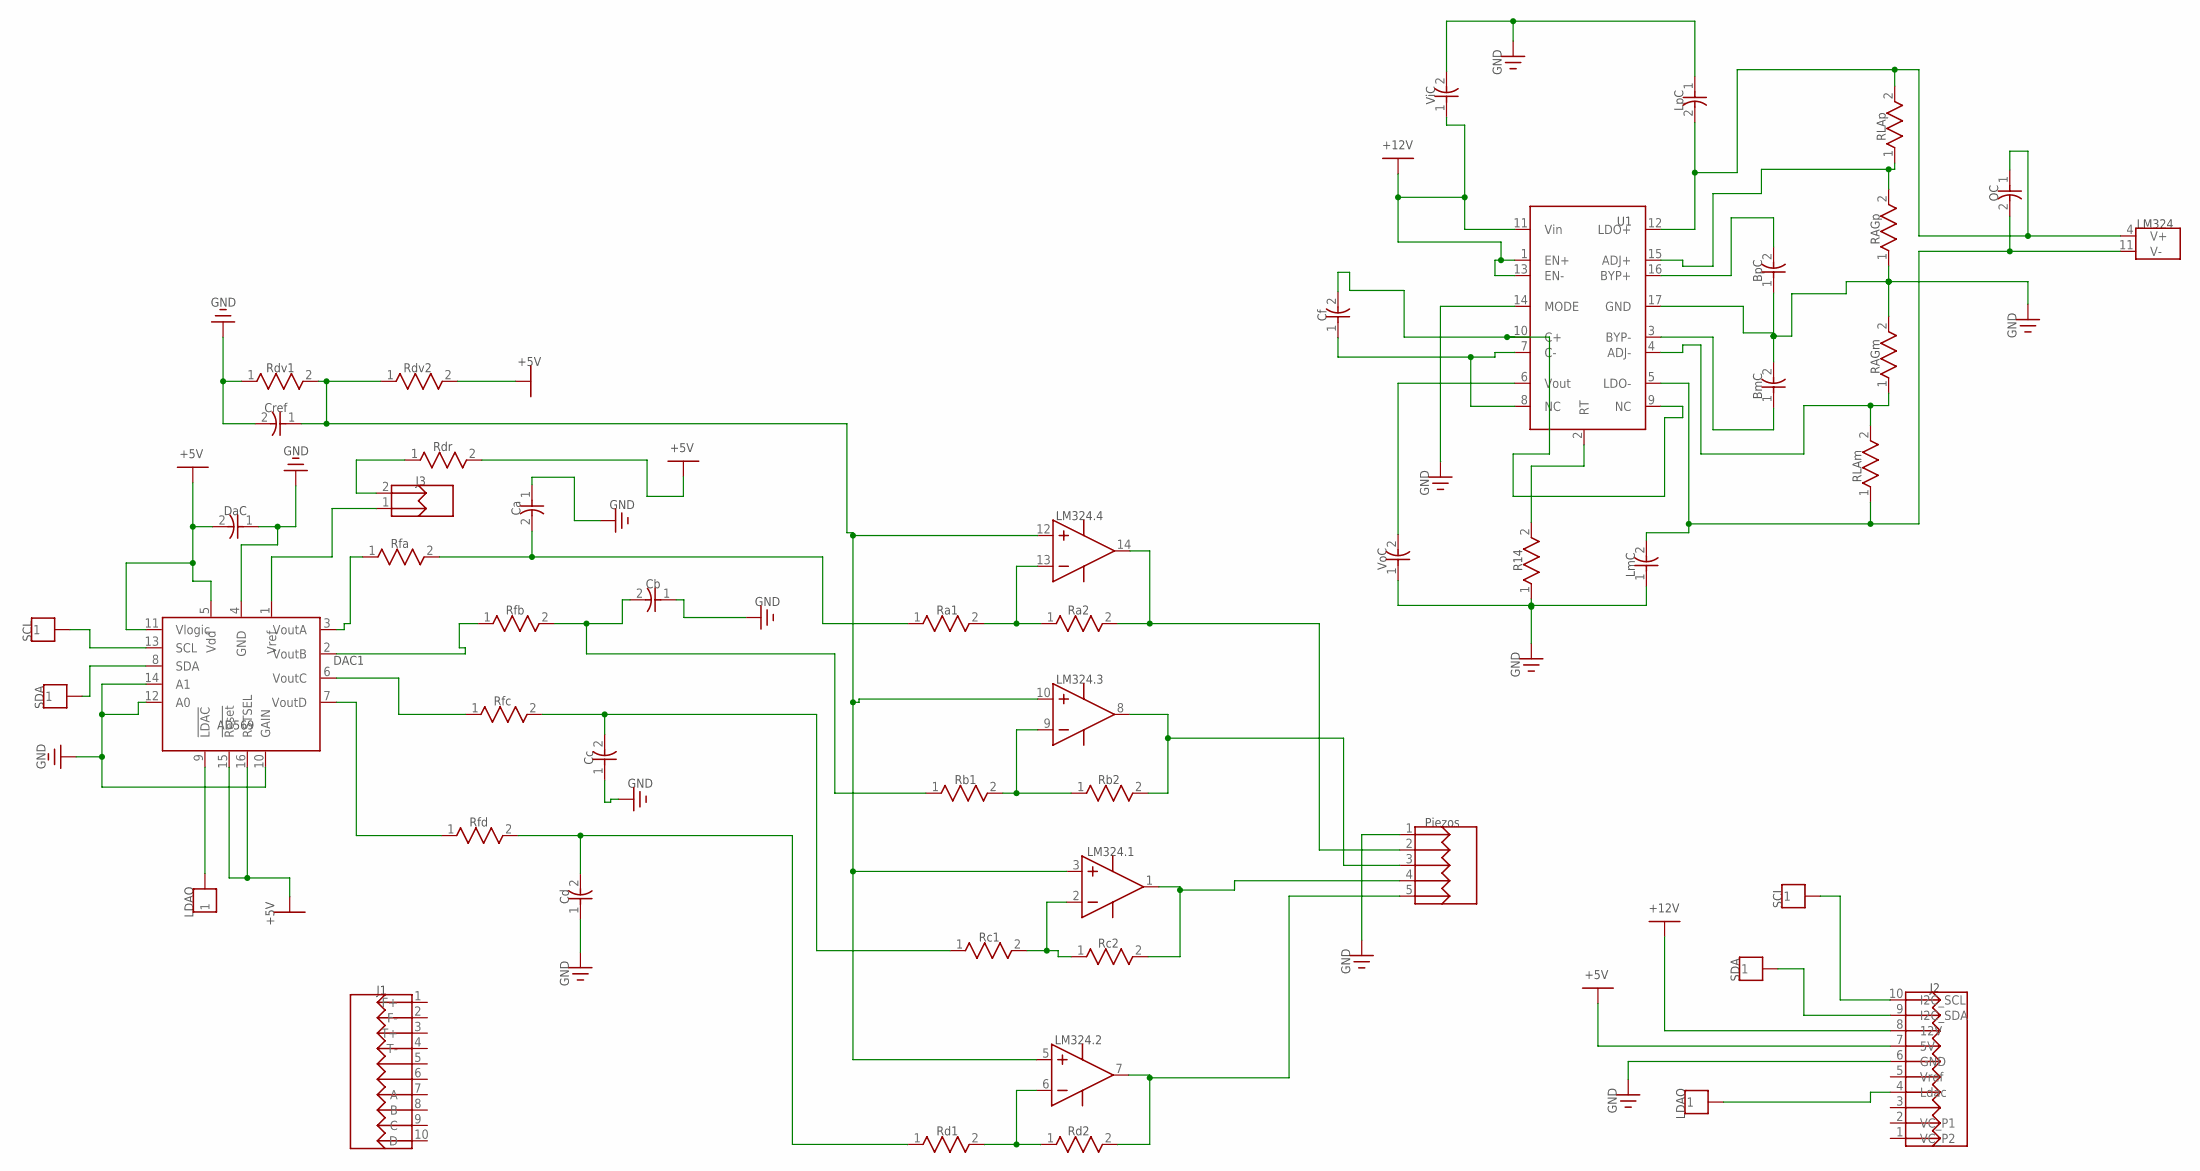
[picture p22: schematic PiezoEagle.sch]

Parts:
BmC: 10nF; CAP_0805
BpC: 10nF; CAP_0805
Ca: 3.2uF; CAP_0805
Cb: 3.2uF; CAP_0805
Cc: 3.2uF; CAP_0805
Cd: 3.2uF; CAP_0805
Cf: 1uF; CAP_0805
Cref: 3.2uF; CAP_0805
DAC1: AD5696RARUZ
DaC: 3.2uF; CAP_0805
J1: 1-644456-0; HDR-1X10T/2.54/25X2
J2: 1-644456-0_3; HDR-1X10T/2.54/25X2
J3: 90131-0121; HDR-2X1T/2.54X2.54/3X5
LM324: LM324AD; SOIC-14/150MIL
LmC: 10uF; CAP_0805
LpC: 10uF; CAP_0805
OC: 10uF; CAP_0805
Piezos: CON5M; HDR-1X5T/2.54/12X2
R14: 200k; RES_0402
RAGm: 100k; RES_0805
RAGp: 100k; RES_0805
RLAm: 800k; RES_0805
RLAp: 800k; RES_0805
Ra1: 5k; RES_0805
Ra2: 30k; RES_0805
Rb1: 5k; RES_0805
Rb2: 30k; RES_0805
Rc1: 5k; RES_0805
Rc2: 30k; RES_0805
Rd1: 5k; RES_0805
Rd2: 30k; RES_0805
Rdr: 10k; RES_0805
Rdv1, Rdv2: 10k; RES_0805
Rfa: 5k; RES_0805
Rfb: 5k; RES_0805
Rfc: 5k; RES_0805
Rfd: 5k; RES_0805
U1: LTC3260; LTC3260_MSOP
ViC: 10uF; CAP_0805
VoC: 10uF; CAP_0805

Connections:
5V: DAC1.5 (Vdd), DAC1.11 (Vlogic), DAC1.15 (!Reset), DAC1.16 (RSTSEL), DaC.2, J2.7 (5V), Rdr.2, Rdv2.2
Gnd: BmC.2, BpC.1, Ca.1, Cb.1, Cc.1, Cd.1, Cref.2, DAC1.4 (GND), DAC1.10 (GAIN), DAC1.12 (A0), DAC1.14 (A1), DaC.1, J2.6 (GND), LmC.1, LpC.1, Piezos.1, R14.1, RAGm.2, RAGp.1, Rdv1.1, U1.14 (MODE), U1.17 (GND), ViC.2, VoC.1
Net_0: LM324.13 (IN-), Ra1.2, Ra2.1
Net_1: LM324.4 (V+), LpC.2, OC.1, RLAp.2, U1.12 (LDO+); also elsewhere on the board
Net_2: Cref.1, LM324.3 (IN+), LM324.5 (IN+), LM324.10 (IN+), LM324.12 (IN+), Rdv1.2, Rdv2.1
Net_3: DAC1.3 (VoutA), Rfa.1; also elsewhere on the board
Net_4: Ca.2, Ra1.1, Rfa.2
Net_5: LM324.9 (IN-), Rb1.2, Rb2.1
Net_6: LM324.8 (OUT), Piezos.3, Rb2.2
Net_7: Cd.2, Rd1.1, Rfd.2
Net_8: LM324.2 (IN-), Rc1.2, Rc2.1
Net_9: LM324.1 (OUT), Piezos.4, Rc2.2
Net_10: DAC1.6 (VoutC), Rfc.1; also elsewhere on the board
Net_11: LM324.6 (IN-), Rd1.2, Rd2.1
Net_12: Cc.2, Rc1.1, Rfc.2
Net_13: DAC1.13 (SCL), J2.10 (I2C_SCL)
Net_14: DAC1.8 (SDA), J2.9 (I2C_SDA)
Net_15: DAC1.9 (!LDAC), J2.4 (Ldac)
Net_16: Cb.2, Rb1.1, Rfb.2
Net_17: Cf.1, U1.7 (C-), U1.8 (NC)
Net_18: Cf.2, U1.9 (NC), U1.10 (C+)
Net_19: LM324.14 (OUT), Piezos.2, Ra2.2
Net_20: J2.8 (12V), U1.1 (EN+), U1.11 (Vin), U1.13 (EN-), ViC.1
Net_21: LM324.11 (V-), LmC.2, OC.2, RLAm.1, U1.5 (LDO-); also elsewhere on the board
Net_22: U1.6 (Vout), VoC.2
Net_23: R14.2, U1.2 (RT)
Net_24: BpC.2, U1.16 (BYP+)
Net_25: DAC1.2 (VoutB), Rfb.1; also elsewhere on the board
Net_26: BmC.1, U1.3 (BYP-)
Net_28: RAGp.2, RLAp.1, U1.15 (ADJ+)
Net_30: RAGm.1, RLAm.2, U1.4 (ADJ-)
Net_31: LM324.7 (OUT), Piezos.5, Rd2.2
Net_32: DAC1.7 (VoutD), Rfd.1; also elsewhere on the board
Net_33: J3.2, Rdr.1
Net_34: DAC1.1 (Vref), J3.1

Notes on the sheet:
BmC
BpC
Cref
DaC
AD569
DAC1
LM324.1
LM324.2
LM324.3
LM324.4
LM324
LmC
LpC
GND
+12V
+5V
SCL
SDA
LDAQ
Piezos
R14
Ra1
Ra2
RAGm
RAGp
Rb1
Rb2
Rc1
Rc2
Rd1
Rd2
Rdr
Rdv1
Rdv2
Rfa
Rfb
Rfc
Rfd
RLAm
RLAp
ViC
VoC
