100dollarhacker/atomic_force_microscope/OpenAFM__converted_files/piezoboard.brd

## EAGLE design OpenAFM__converted_files/piezoboard.brd (continued)

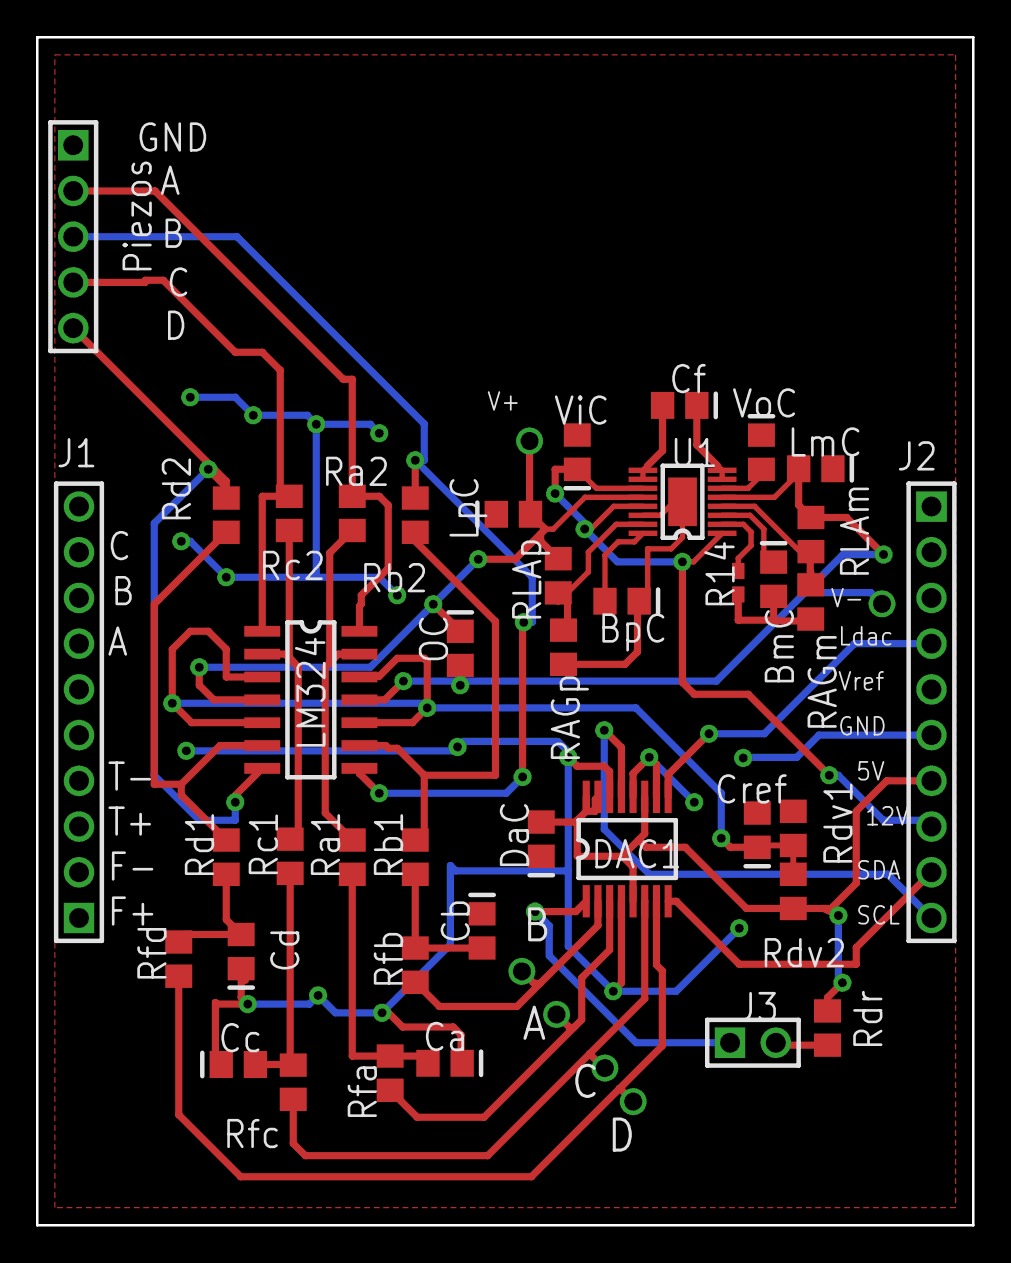
[picture p23: board piezoboard.brd from above]

Board: 2 copper layers, 52.0 x 66.0 mm, 47 parts (0 on the bottom side), 35 nets.

Other parts of the board:
Pad1, Pad2, Pad3, Pad4, Pad5, Pad6: PAD; Pad

Their connections:
Net_1: Pad5.1; also elsewhere on the board
Net_3: Pad3.1; also elsewhere on the board
Net_10: Pad2.1; also elsewhere on the board
Net_21: Pad6.1; also elsewhere on the board
Net_25: Pad4.1; also elsewhere on the board
Net_32: Pad1.1; also elsewhere on the board
