100dollarhacker/atomic_force_microscope/firmware_new/maincontroller/DAC_AD5696.cpp

/*************************************************************************
 * Copyright 2012(c) Analog Devices, Inc.
 *
 * All rights reserved.
 *
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
********************************************************************************
*   SVN Revision: 776
*******************************************************************************/

/******************************************************************************/
/***************************** Include Files **********************************/
/******************************************************************************/
#include "DAC_AD5696.h"


/******************************************************************************/
/************************ Functions Definitions *******************************/
/******************************************************************************/

/***************************************************************************//**
 * @brief Initializes the device.
 *
 * @param AD569X - Device version.
 *                 Example: AD5694  - 12-bit DAC(no internal vRef).
 *                          AD5696  - 16-bit DAC(no internal vRef).
 *                          AD5694R - 12-bit DAC(with internal vRef).
 *                          AD5695R - 14-bit DAC(with internal vRef).
 *                          AD5695R - 16-bit DAC(with internal vRef).
 * @param a1LogicLevel - Address pin A1.
 * @param a0LogicLevel - Address pin A0.
 *
 * @return status - Result of the initialization procedure.
 *          Example: 0x0 - I2C peripheral was not initialized.
 *                 0x1 - I2C peripheral is initialized.
*******************************************************************************/
unsigned char DAC_AD5696::Init(unsigned char numBits, unsigned char a1LogicLevel,
                          unsigned char a0LogicLevel)
{
    unsigned char status = 0;

	deviceBitsNumber = numBits;
    
    /* Store logic levels of A1 and A0 that set the two LSBs of the slave 
       address. */
       
    addressPinA1 = a1LogicLevel << 1;
    addressPinA0 = a0LogicLevel << 0;

	// figure out the maximum value (digital) of the DAC
	maxValue = 1U;
	//Serial.println(maxValue);
	for (int i = 0; i < deviceBitsNumber - 1; i++)
	{
		maxValue = maxValue << 1;
		maxValue |= 1U;
		//Serial.println(maxValue);
	}
	maxValueF = maxValue;
    
    return status;
}

/***************************************************************************//**
 * @brief Puts the device in a specific power mode.
 *
 * @param channel - Channel option. Only one channel may be selected.
 *                  Example: AD569X_ADDR_DAC_A
 *                           AD569X_ADDR_DAC_B
 *                           AD569X_ADDR_DAC_C
 *                           AD569X_ADDR_DAC_D         
 * @param pwrMode - Power mode of the device.
 *                  Example: AD569X_PD_NORMAL   - Normal operation
 *                           AD569X_PD_1K       - 1 kOhm to GND
 *                           AD569X_PD_100K     - 100 kOhm to GND
 *                           AD569X_PD_3STATE   - Three-state
 *                               
 *
 * @return none.
*******************************************************************************/
void DAC_AD5696::PowerMode(unsigned char channel, unsigned char pwrMode)
{    
    switch(channel)
    {
        case AD569X_ADDR_DAC_A:
            currentPowerRegValue &= ~AD569X_PWR_PDA(0x3);   // Clear power bits
            currentPowerRegValue |= AD569X_PWR_PDA(pwrMode);
            break;
        case AD569X_ADDR_DAC_B:
            currentPowerRegValue &= ~AD569X_PWR_PDB(0x3);
            currentPowerRegValue |= AD569X_PWR_PDB(pwrMode);
            break;
        case AD569X_ADDR_DAC_C:
            currentPowerRegValue &= ~AD569X_PWR_PDC(0x3);
            currentPowerRegValue |= AD569X_PWR_PDC(pwrMode);
            break;
        case AD569X_ADDR_DAC_D:
            currentPowerRegValue &= ~AD569X_PWR_PDD(0x3);
            currentPowerRegValue |= AD569X_PWR_PDD(pwrMode);
            break;
    }
    SetInputRegister(AD569X_CMD(AD569X_CMD_POWERMODE) | 
                             currentPowerRegValue);
}

/***************************************************************************//**
 * @brief Resets the device(clears the outputs to either zero scale or 
          midscale).
 *
 * @param resetOutput - The output values of the device at power-up or reset.
 *                      Example: 
 *                    AD569X_RST_ZERO_SCALE - outputs are cleared to zero scale.
 *                    AD569X_RST_MIDSCALE   - outputs are cleared to midscale.
 *
 * @return none.
*******************************************************************************/
void DAC_AD5696::Reset(unsigned char resetOutput)
{
    if(resetOutput)
    {
        AD569X_RSTSEL_HIGH;
    }
    else
    {
        AD569X_RSTSEL_LOW;
    }
    SetInputRegister(AD569X_CMD(AD569X_CMD_SOFT_RESET));
}

/***************************************************************************//**
 * @brief Writes a 24-bit data-word to the Input Register of the device.
 *
 * @param registerValue - Value of the register.
 *
 * @return none.
*******************************************************************************/
void DAC_AD5696::SetInputRegister(unsigned long registerValue)
{
	//unsigned char registerWord[3] = { 0, 0, 0 };
	unsigned char* dataPointer = (unsigned char*)&registerValue;

	//registerWord[0] = dataPointer[2];
	//registerWord[1] = dataPointer[1];
	//registerWord[2] = dataPointer[0];

	const char outbuffer[3] = { dataPointer[2], dataPointer[1], dataPointer[0] };
	I2C_Write(AD569X_5MSB_SLAVE_ADDR | addressPinA1 | addressPinA0,
		outbuffer,
		3,
		1);
}

/***************************************************************************//**
 * @brief Select internal or external voltage reference.
 *
 * @param vRefMode - Voltage reference option.
 *                   Example: AD569X_INT_REF_ON  - Internal reference is used.
 *                            AD569X_INT_REF_OFF - External reference is used.
 *
 * @return none.
*******************************************************************************/
void DAC_AD5696::InternalVoltageReference(unsigned char vRefMode)
{
    SetInputRegister(AD569X_CMD(AD569X_CMD_INT_REF_SETUP) | 
                            vRefMode);
	/*Wire.beginTransmission(AD569X_5MSB_SLAVE_ADDR | addressPinA1 | addressPinA0);
	Wire.write(B01111111);
	Wire.write(0xFF);
	Wire.write(0xFF);
	Wire.endTransmission();*/
}

/***************************************************************************//**
 * @brief Write data to the Input Register or to DAC Register of a channel.
 *
 * @param writeCommand - The write command option.
 *                       Example: 
*                        AD569X_CMD_WR_INPUT_N    - Write to Input Register n.
 *                       AD569X_CMD_WR_UPDT_DAC_N - Write to and update DAC n.
 * @param channel - Channel option. Any combination of DAC channels can be 
                    selected.
 *                  Example: AD569X_ADDR_DAC_A
 *                           AD569X_ADDR_DAC_B
 *                           AD569X_ADDR_DAC_C
 *                           AD569X_ADDR_DAC_D
 * @param data -  Data value to write.
 *
 * @return none.
*******************************************************************************/
void DAC_AD5696::WriteFunction(unsigned char writeCommand, 
                          unsigned char channel, 
                          unsigned short data)
{
    unsigned char shiftValue = 0;
    
    /* Different types of devices have different data bits positions. */
    shiftValue = 16 - deviceBitsNumber;
    SetInputRegister(AD569X_CMD(writeCommand) |
                            AD569X_ADDR(channel) | 
                            ((long)AD569X_DATA_BITS(data) << shiftValue));
}

/***************************************************************************//**
 * @brief Reads back the binary value written to one of the channels.
 *
 * @param dacChannelAddr - Channel address.Channel option. Any combination of 
 *                         DAC channels can be selected.
 *                         Example: AD569X_ADDR_DAC_A
 *                                  AD569X_ADDR_DAC_B
 *                                  AD569X_ADDR_DAC_C
 *                                  AD569X_ADDR_DAC_D 
 *
 * @return 12-bit value of the selected channel.
*******************************************************************************/
unsigned short DAC_AD5696::ReadBack(unsigned char dacChannelAddr)
{
	unsigned long channelValue = 0;
	unsigned char shiftValue = 0;
	//unsigned char buffer[2]    = {0, 0};

	/* Different types of devices have different data bits positions. */
	shiftValue = 16 - deviceBitsNumber;
	//buffer[0] = dacChannelAddr;
	const char outbuffer[2] = { dacChannelAddr , 0 };
	I2C_Write(AD569X_5MSB_SLAVE_ADDR | addressPinA1 | addressPinA0,
		outbuffer,
		1,
		0);

	unsigned char inbuffer[2] = { 0, 0 };
	I2C_Read(AD569X_5MSB_SLAVE_ADDR | addressPinA1 | addressPinA0,
		inbuffer,
		2,
		1);

	channelValue = ((long)inbuffer[0] << 8) | inbuffer[1];
	channelValue >>= shiftValue;

	return channelValue;
}

/***************************************************************************//**
 * @brief Selects the output voltage of the selected channel.
 *
 * @param channel - Channel option. Channel option. Any combination of DAC 
 *                  channels can be selected.
 *                  Example: AD569X_ADDR_DAC_A
 *                           AD569X_ADDR_DAC_B
 *                           AD569X_ADDR_DAC_C
 *                           AD569X_ADDR_DAC_D
 * @param outputVoltage - Output voltage value.
 * @param vRef - Value of the voltage reference used. If GAIN pin is tied to Vdd
 *               vRef value is multiplied by 2 inside this function.
 *
 * @return The actual value of the output voltage.
*******************************************************************************/
float DAC_AD5696::SetVoltage(unsigned char channel, 
                        float outputVoltage, 
                        float vRef)
{
    //unsigned short binaryValue   = 0;
    //float          actualVoltage = 0;
    //
    //if(vRef == 0)
    //{
    //    vRef = 5.0;
    //}
    ////vRef *= (AD569X_GAIN_STATE != 0) ? 2 : 1;
    //binaryValue = (unsigned short)(outputVoltage * (1ul << deviceBitsNumber) / 
    //                              vRef);
    //WriteFunction(AD569X_CMD_WR_UPDT_DAC_N, channel, binaryValue);
    //actualVoltage = (float)(vRef * binaryValue) / (1ul << deviceBitsNumber);
    //
    //return actualVoltage;

	uint16_t value = (outputVoltage / vRef) * (maxValueF);

	//Serial.println(value);


	// need to shift it?
	value = value << (16 - deviceBitsNumber);

	//Serial.println(value);

	channel &= B00001111;  // smash any of the higher bits, not used here.
	uint8_t lsb = value;
	uint8_t msb = value >> 8;

	/*Serial.println(msb);
	Serial.println(lsb);
	Serial.println(AD569X_5MSB_SLAVE_ADDR | addressPinA1 | addressPinA0);
	Serial.println(B00110000 | channel);*/

	Wire.beginTransmission(AD569X_5MSB_SLAVE_ADDR | addressPinA1 | addressPinA0);
	Wire.write(B00110000 | channel);  // set and update DAC channels;
	Wire.write(msb);
	Wire.write(lsb);
	Wire.endTransmission();
}

void DAC_AD5696::SetVoltage(unsigned char channel, uint16_t outputVoltage)
{


	uint16_t value = outputVoltage + (maxValueF/2);

  // Serial.print("Channel: ");
  // Serial.print(channel);
  // Serial.print("  value: ");
	// Serial.println(value);


	// need to shift it?
	value = value << (16 - deviceBitsNumber);

	//Serial.println(value);

	channel &= B00001111;  // smash any of the higher bits, not used here.
	uint8_t lsb = value;
	uint8_t msb = value >> 8;

	/*Serial.println(msb);
	Serial.println(lsb);
	Serial.println(AD569X_5MSB_SLAVE_ADDR | addressPinA1 | addressPinA0);
	Serial.println(B00110000 | channel);*/

	Wire.beginTransmission(AD569X_5MSB_SLAVE_ADDR | addressPinA1 | addressPinA0);
	Wire.write(B00110000 | channel);  // set and update DAC channels;
	Wire.write(msb);
	Wire.write(lsb);
	Wire.endTransmission();
}


/***************************************************************************//**
* @brief Selects the output voltage of the selected channel.
*
* @param channel - Channel option. Channel option. Any combination of DAC
*                  channels can be selected.
*                  Example: AD569X_ADDR_DAC_A
*                           AD569X_ADDR_DAC_B
*                           AD569X_ADDR_DAC_C
*                           AD569X_ADDR_DAC_D
* @param value - The value to set to.
*
* @return 0 - success
*******************************************************************************/
int DAC_AD5696::SetOutput(uint8_t channel,
	uint16_t value)
{
	channel &= B00001111;  // smash any of the higher bits, not used here.
	uint8_t lsb = value;
	uint8_t msb = value >> 8;

	Wire.beginTransmission(AD569X_5MSB_SLAVE_ADDR | addressPinA1 | addressPinA0);
	Wire.write(B00110000 | channel);  // set and update DAC channels;
	Wire.write(lsb);  // set to half voltage
	Wire.write(msb);
	Wire.endTransmission();

	return 0;
}
