100dollarhacker/atomic_force_microscope/(commit log)

2023-07-18 Files needed to create nono sized tip
    [AFM_tiip_creator_part1.stl, AFM_tiip_creator_part2.stl]
2023-07-21 old OpenAFM schematics
    [Piezo BOM.xlsx, PiezoEagle.sch, main board BOM.xlsx, mainboard.brd, mainboard.sch, piezoboard.brd]
2023-08-17 This is a very basic but working DAC
    [AFM_tiip_creator_part1.stl, AFM_tiip_creator_part2.stl]
2023-10-08 POC fine mechanical and coarse mechanical
    [base.stl, finemovement.stl, gears.stl, main_body.stl, moving_platform.stl, small_gears.stl]
2023-10-12 Nano probe holder
    [afm_nanoprobe_holder__down.stl, afm_nanoprobe_holder__up.stl]
2024-03-05 initial electoring circuits added
    [AFM_Power_board.brd, AFM_Power_board.sch, AFM_QFM_input.brd, AFM_QFM_input.sch, AFM_QFM_input_patial.brd, AFM_QFM_input_patial.sch, AFM_QFM_sensor.brd, AFM_QFM_sensor.sch]
2024-04-06 movied power lines to right position
    [AFM_Power_board.brd]
2024-05-19 Charge pump with his own power source
    [AFM_QFM_Piezo_controller.brd, AFM_QFM_Piezo_controller.sch]
2024-07-07 some last minute fixs
    [DAC_AD5696.cpp, DAC_AD5696.h, maincontroller.ino]
2024-07-08 Added frequency sensor
2024-08-04 afm sensor holder with bolts holders
    [afm_nanoprobe_holder__down.stl]
2024-08-04 upper parth with bolt holder
    [afm_nanoprobe_holder__up.stl]
2024-08-17 new functions and samples
    [z_sample_1.ods, z_sample_2.ods, z_sample_3.ods]
2024-11-04 newer electroincs
    [AFM_Power_board__ALL_SMD.brd, AFM_Power_board__ALL_SMD.sch, AFM_Power_board__NEW.brd, AFM_Power_board__NEW.sch, AFM_Power_board__NEW_SMD.brd, AFM_Power_board__NEW_SMD.sch, AFM_QFM_Piezo_controller.brd, AFM_QFM_Piezo_controller.sch]
2024-12-30 BOM - Bill Of Materials for all the boards
    [AllBoardsBom.xlsx]
2024-12-30 Updated to boards. Changes reflects fixes needed to PCBWay boards
    [5LongConnector.brd, 5LongConnector.sch, AFM_Power_board__NEW_SMD.brd, AFM_Power_board__NEW_SMD.sch, AFM_QFM_Piezo_controller.brd, AFM_QFM_Piezo_controller.sch, AFM_QFM_input.brd, AFM_QFM_input.sch]
2024-12-30 removed unused files
    [AFM_Power_board__ALL_SMD.brd, AFM_Power_board__ALL_SMD.sch]
2024-12-30 removed old
    [AFM_QFM_input__smd_xor.brd, AFM_QFM_input__smd_xor.sch]
2024-12-30 remove old files
    [AFM_Power_board.brd, AFM_Power_board.sch, AFM_Power_board__NEW.brd, AFM_Power_board__NEW.sch, AFM_QFM_input_patial.brd, AFM_QFM_input_patial.sch, AFM_piezo_controller.sch, AFM_piezo_controller2.brd]
2025-03-19 simple gui added, mainly buttons that doesn't do a thing and a plot with fake data
2025-03-21 added scan thread and other buttons
2025-03-22 most of the buttons are functional, not tested on real device yet
2025-05-20 make serail a thread
2025-05-23 adding ability to trace surface
2025-09-26 removing tiny bug which made me a lot of troubles
    [maincontroller.ino]
2025-10-11 name changed and fixed direction of convergence
    [maincontroller.ino]
2025-10-11 fix another issue now it's able to scan
    [maincontroller.ino]
2025-10-20 add 500ms delay to x-scanning movement otherwise all data in X-axis is the same and disable 32K restriction
2025-10-24 example images
    [image.csv, image2.csv]
2025-11-10 some fixes for stabilization
    [maincontroller.ino]
