100dollarhacker/atomic_force_microscope/(notices)

Notices in the files:
parts and their libraries:
SparkFun-Boards: Licensing: Creative Commons ShareAlike 4.0 International - https://creativecommons.org/licenses/by-sa/4.0
AD5696: COPYRIGHT: Copyright (C) 2024 Ultra Librarian. All rights reserved.
Wurth_EMC Components_WE-CBF: Copyright: Würth Elektronik
